mhonda0119/Passion-v2/Inventor/Passion-v2-6/DMM/battery-stopper-assembly-multiple.stp

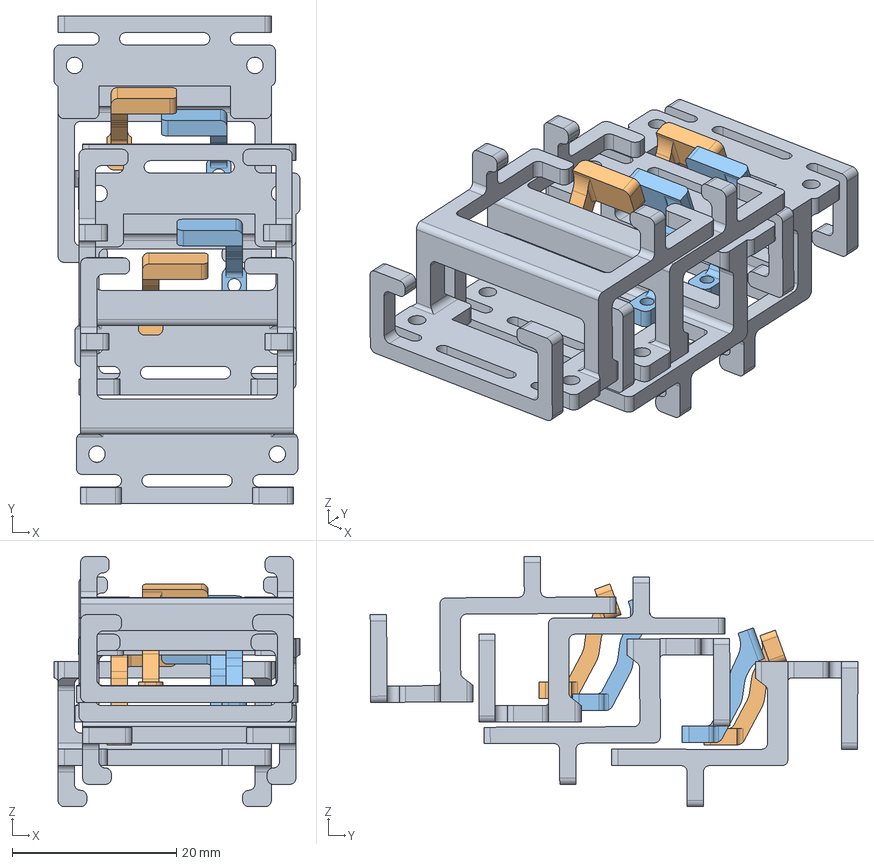
[picture p1: CAD file, 2025-02-09]
Inventor/Passion-v2-6/DMM/battery-stopper-assembly-multiple.stp
30.0 x 59.5 x 30.5 mm
battery-stopper-3 x 4
battery-stopper-1 x 2
battery-stopper-1_1 x 2
