mhonda0119/Passion-v2/Eagle/circuit-shape.dxf

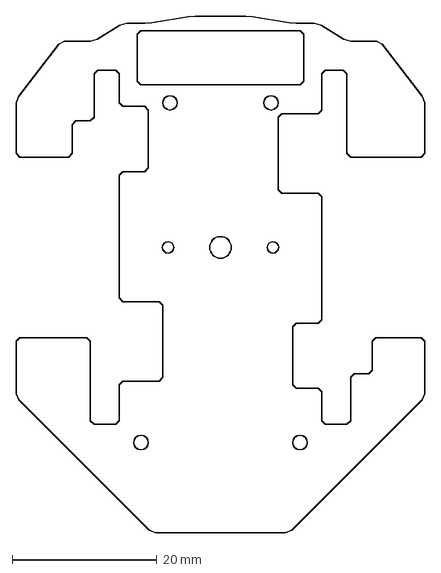
[picture p2: CAD file, 2025-03-03]
Eagle/circuit-shape.dxf
56.5 x 71.5 mm
