mhonda0119/Passion-v2/Inventor/Passion-v2-5/Origin/STEP/7075/motormount-l-v2-4.stp

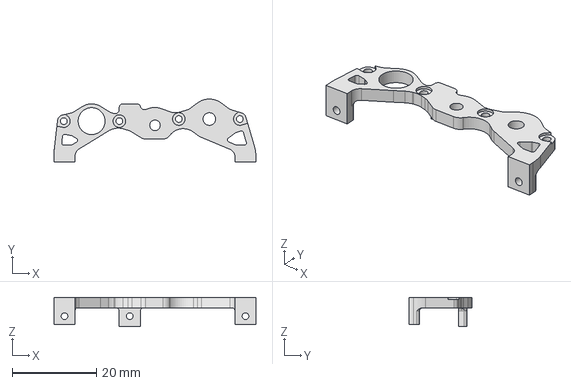
[picture p3: CAD file, 2025-02-07]
Inventor/Passion-v2-5/Origin/STEP/7075/motormount-l-v2-4.stp
48.0 x 14.9 x 7.00 mm
