mhonda0119/Passion-v2/Inventor/Passion-v2-5/Origin/STEP/POM/fan-concreate-v2-4.stp

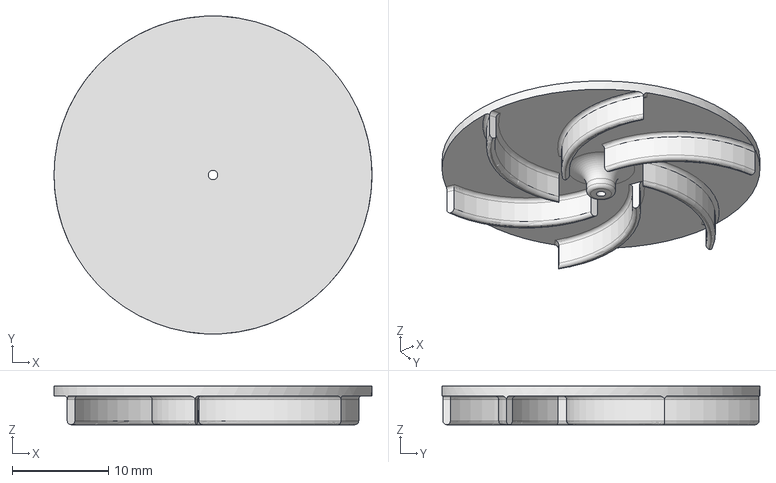
[picture p4: CAD file, 2025-02-07]
Inventor/Passion-v2-5/Origin/STEP/POM/fan-concreate-v2-4.stp
33.0 x 33.0 x 4.00 mm
