mhonda0119/Passion-v2/Inventor/Passion-v2-5/STEP/chassis.stp

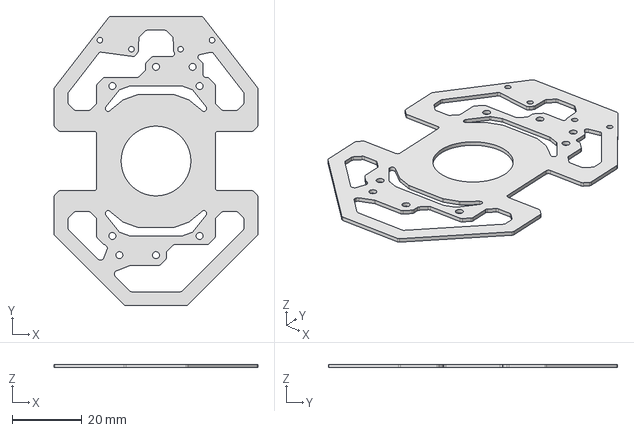
[picture p5: CAD file, 2025-02-08]
Inventor/Passion-v2-5/STEP/chassis.stp
58.5 x 83.0 x 1.00 mm
