mhonda0119/Passion-v2/Inventor/Passion-v2-5/試作/encodersupporter.stp

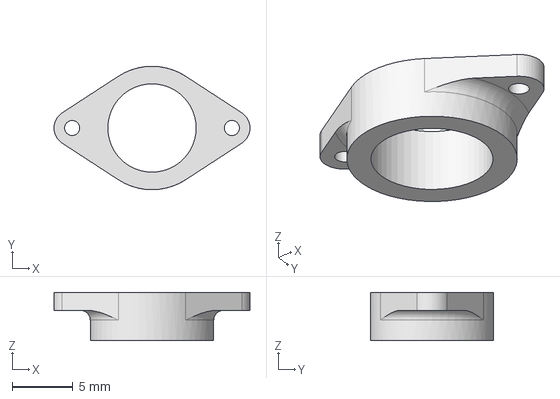
[picture p6: CAD file, 2025-02-07]
Inventor/Passion-v2-5/試作/encodersupporter.stp
16.2 x 10.2 x 4.00 mm
