mhonda0119/Passion-v2/Inventor/Passion-v2-6/CarbonLab/chassis.stp

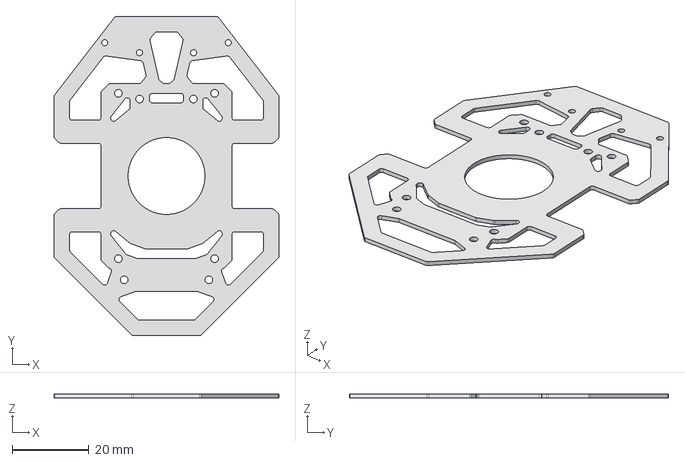
[picture p7: CAD file, 2025-02-09]
Inventor/Passion-v2-6/CarbonLab/chassis.stp
58.5 x 83.0 x 1.00 mm
