mhonda0119/Passion-v2/Inventor/Passion-v2-6/DMM/battery-stopper-1.stp

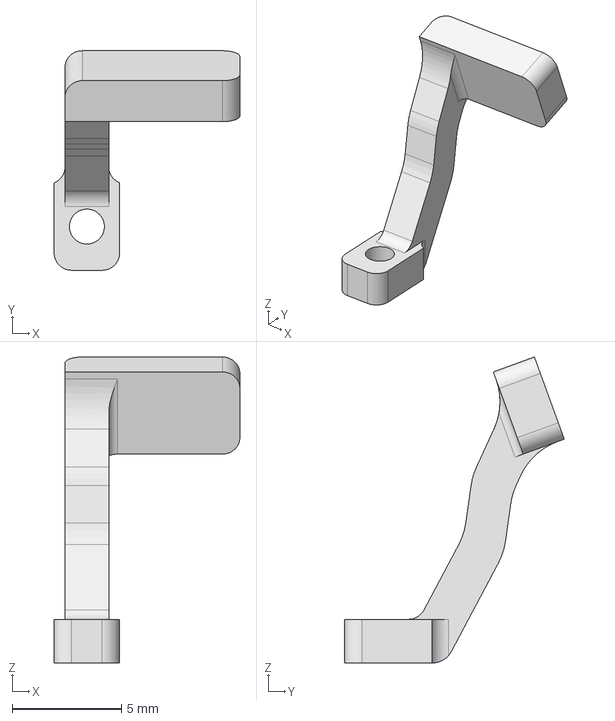
[picture p8: CAD file, 2025-02-09]
Inventor/Passion-v2-6/DMM/battery-stopper-1.stp
8.50 x 10.0 x 14.0 mm
