mhonda0119/Passion-v2/Inventor/Passion-v2-6/fanmotor-mount-1.stp

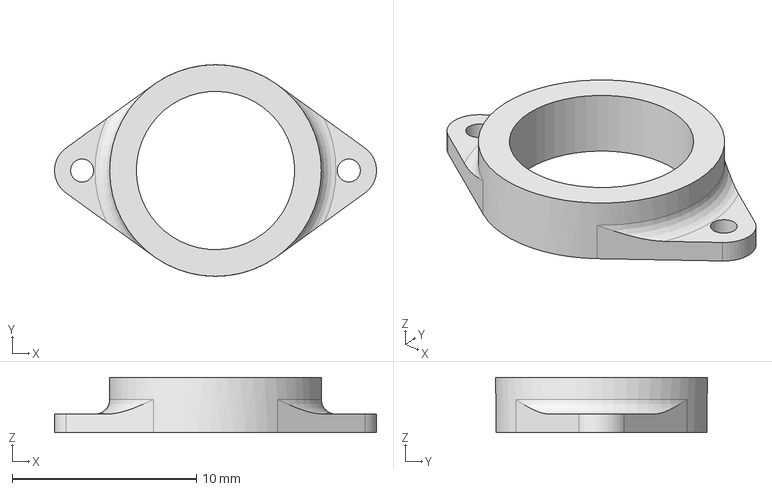
[picture p9: CAD file, 2025-03-03]
Inventor/Passion-v2-6/fanmotor-mount-1.stp
17.5 x 11.5 x 3.00 mm
