mhonda0119/Passion-v2/Inventor/Passion-v2-6/JLCPCB/sensorbase.stp

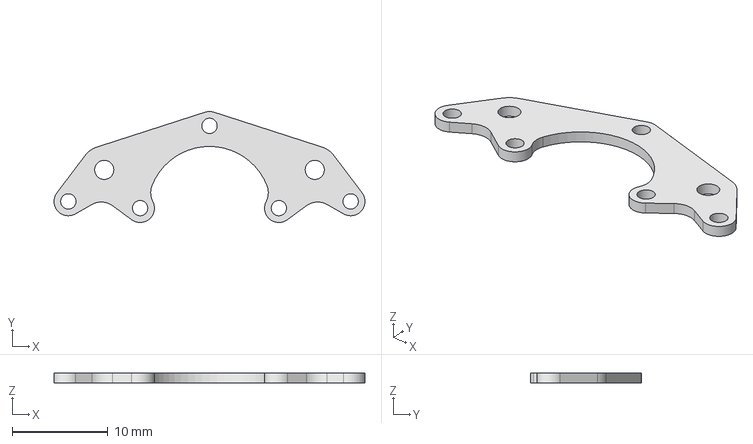
[picture p10: CAD file, 2025-02-09]
Inventor/Passion-v2-6/JLCPCB/sensorbase.stp
32.5 x 11.6 x 1.00 mm
