mhonda0119/Passion-v2/Inventor/Passion-v2-6/Origin/encodersupporter.stp

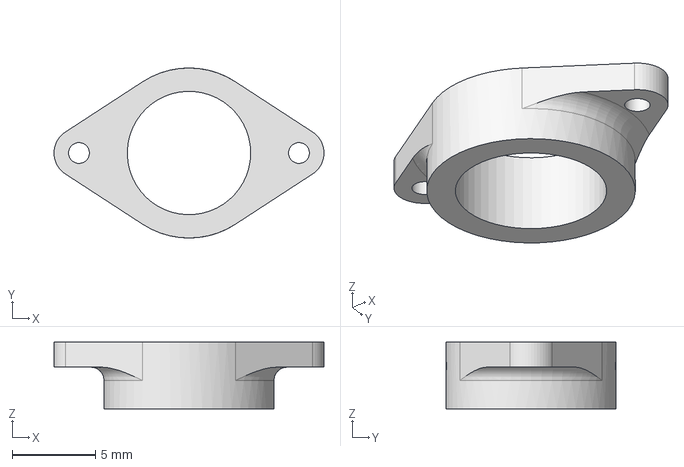
[picture p11: CAD file, 2025-03-03]
Inventor/Passion-v2-6/Origin/encodersupporter.stp
16.2 x 10.2 x 4.00 mm
