mhonda0119/Passion-v2/Eagle/sensor-hub-fr-fl.dxf

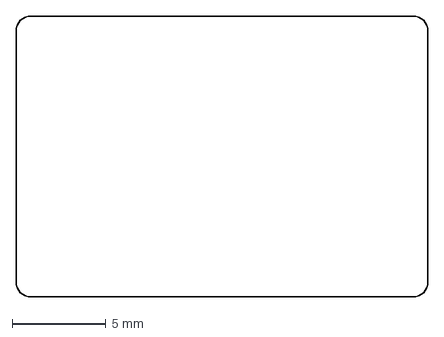
[picture p12: CAD file, 2025-03-03]
Eagle/sensor-hub-fr-fl.dxf
22.0 x 15.0 mm
