mhonda0119/Passion-v2/Inventor/Passion-v2-5/STEP/motorsupporter.stp

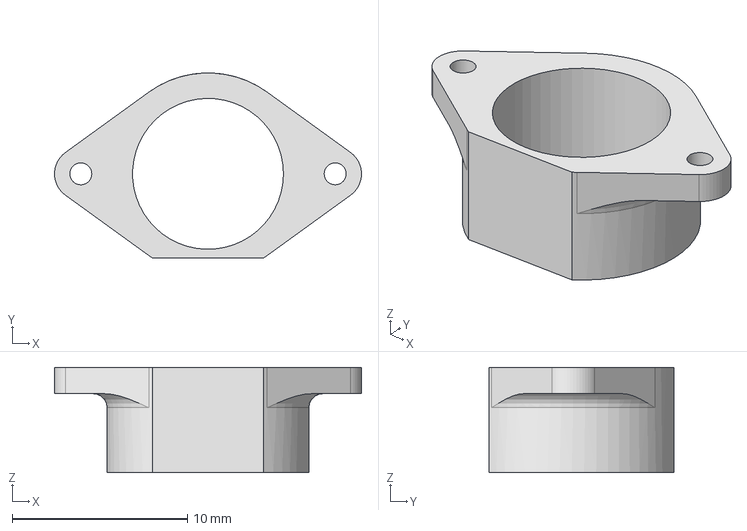
[picture p13: CAD file, 2025-02-08]
Inventor/Passion-v2-5/STEP/motorsupporter.stp
17.5 x 10.6 x 6.00 mm
