mhonda0119/Passion-v2/Inventor/Passion-v2-6/DMM/encoder-gear-spacer-multiple.stp

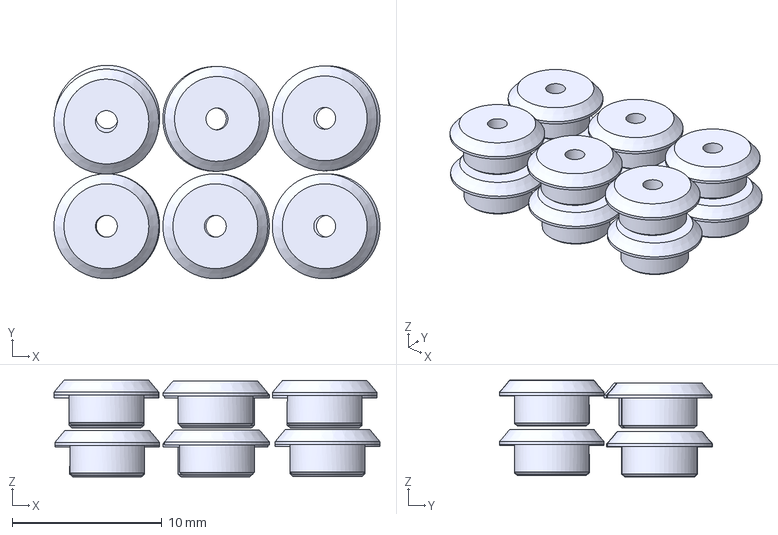
[picture p14: CAD file, 2025-02-09]
Inventor/Passion-v2-6/DMM/encoder-gear-spacer-multiple.stp
21.7 x 14.2 x 6.44 mm
Encoder-Gear-Spacer x 12
