mhonda0119/Passion-v2/Inventor/Passion-v2-6/JLCPCB/fan-concreate.stp

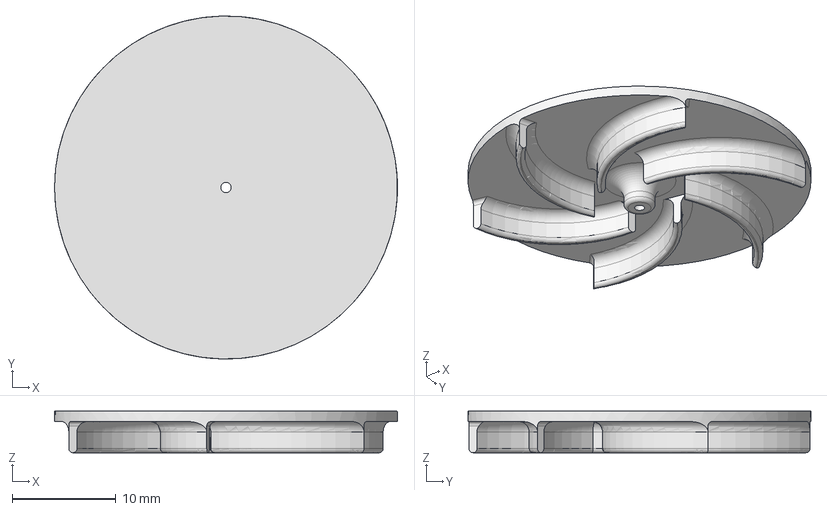
[picture p15: CAD file, 2025-02-09]
Inventor/Passion-v2-6/JLCPCB/fan-concreate.stp
33.0 x 33.0 x 4.00 mm
