mhonda0119/Passion-v2/Eagle/sensor-hub-lr.dxf

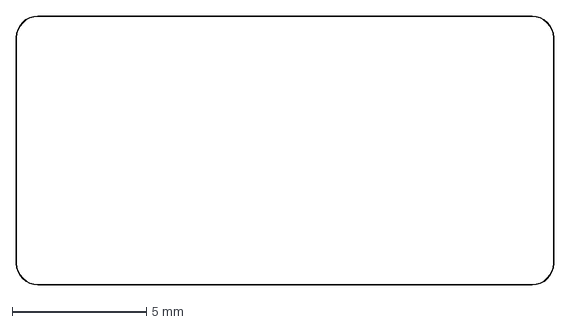
[picture p16: CAD file, 2025-03-03]
Eagle/sensor-hub-lr.dxf
20.0 x 10.0 mm
