mhonda0119/Passion-v2/Inventor/Passion-v2-5/試作/sensormount -fl.stp

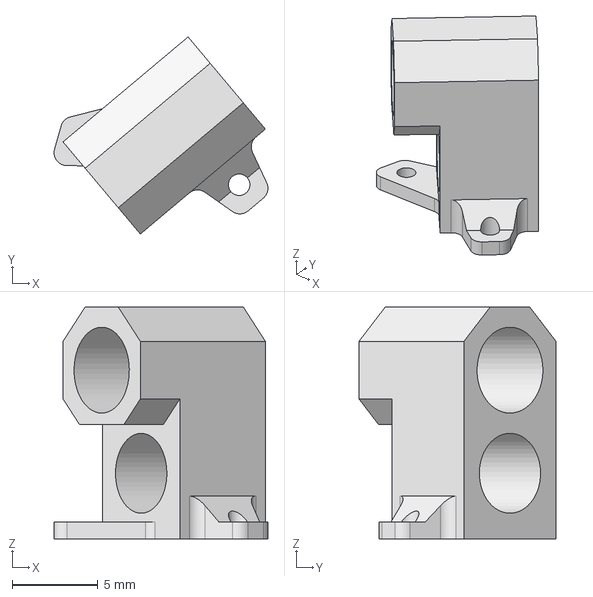
[picture p17: CAD file, 2025-02-07]
Inventor/Passion-v2-5/試作/sensormount -fl.stp
12.4 x 11.5 x 13.5 mm
