mhonda0119/Passion-v2/Inventor/Passion-v2-6/JLCPCB/motormount-l.stp

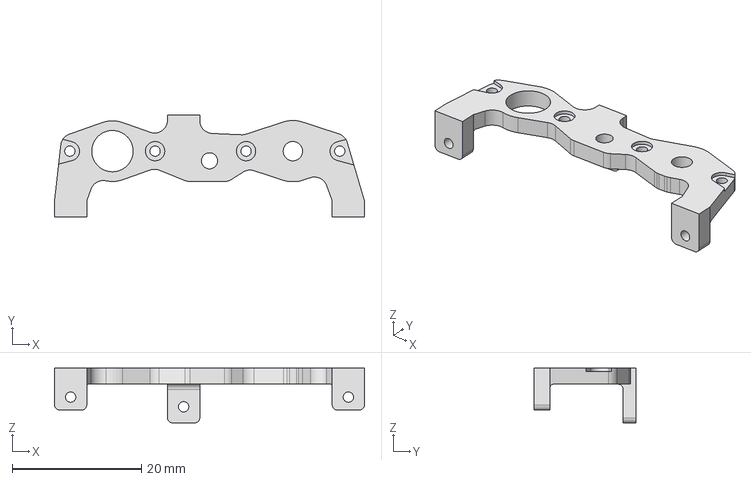
[picture p18: CAD file, 2025-02-09]
Inventor/Passion-v2-6/JLCPCB/motormount-l.stp
48.0 x 15.8 x 8.50 mm
