mhonda0119/Passion-v2/Eagle/circuit-tplace.dxf

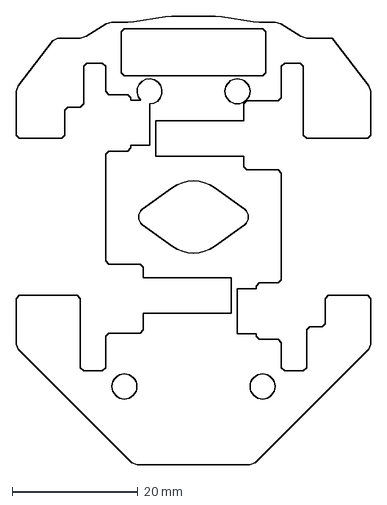
[picture p19: CAD file, 2025-02-09]
Eagle/circuit-tplace.dxf
56.5 x 71.5 mm
