mhonda0119/Passion-v2/Inventor/Passion-v2-5/試作/motormount-l.stp

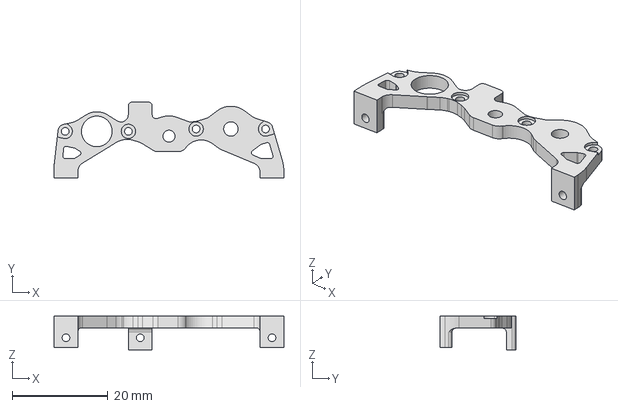
[picture p20: CAD file, 2025-02-07]
Inventor/Passion-v2-5/試作/motormount-l.stp
48.0 x 15.8 x 7.00 mm
