mhonda0119/Passion-v2/Inventor/Passion-v2-5/試作/frontsensorholder.stp

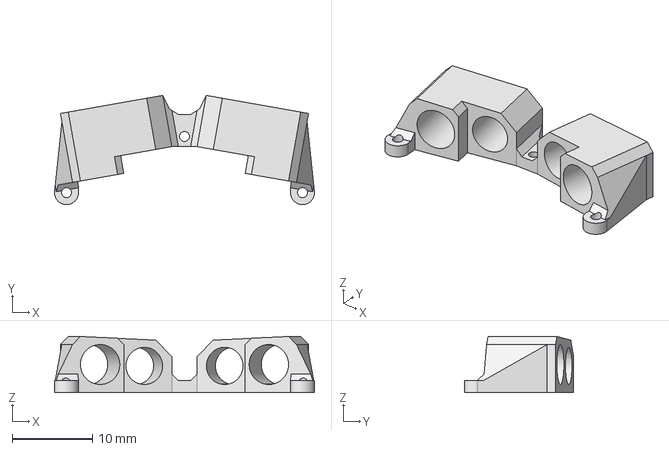
[picture p21: CAD file, 2025-02-07]
Inventor/Passion-v2-5/試作/frontsensorholder.stp
32.5 x 13.6 x 7.00 mm
