mhonda0119/Passion-v2/Inventor/Passion-v2-6/DMM/battery-stopper-3.stp

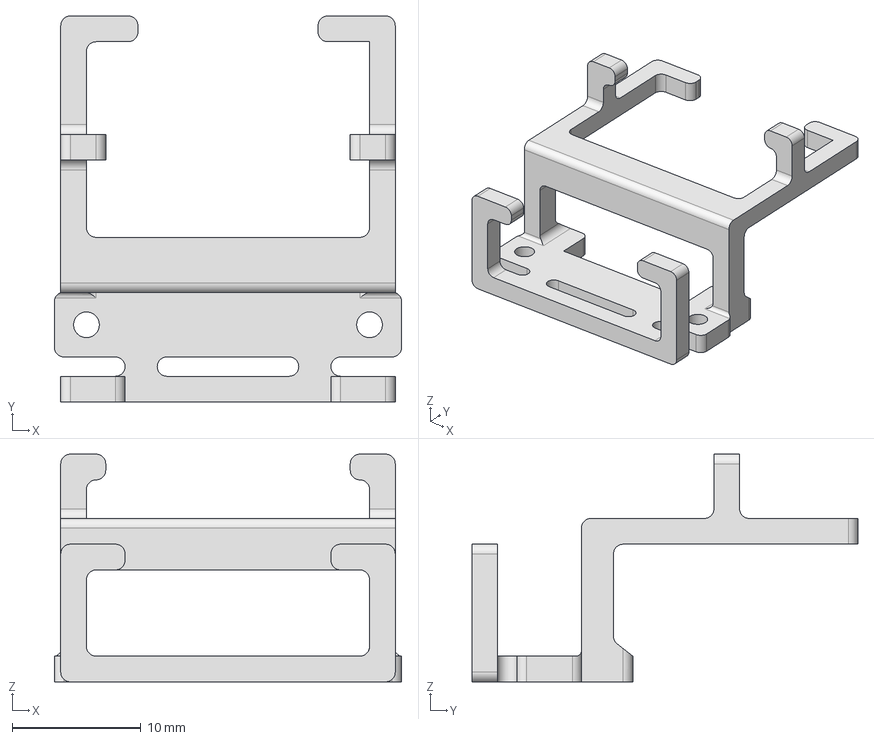
[picture p22: CAD file, 2025-02-09]
Inventor/Passion-v2-6/DMM/battery-stopper-3.stp
27.0 x 30.0 x 17.7 mm
