mhonda0119/Passion-v2/Inventor/Passion-v2-6/DMM/Encoder-Gear-Spacer.stp

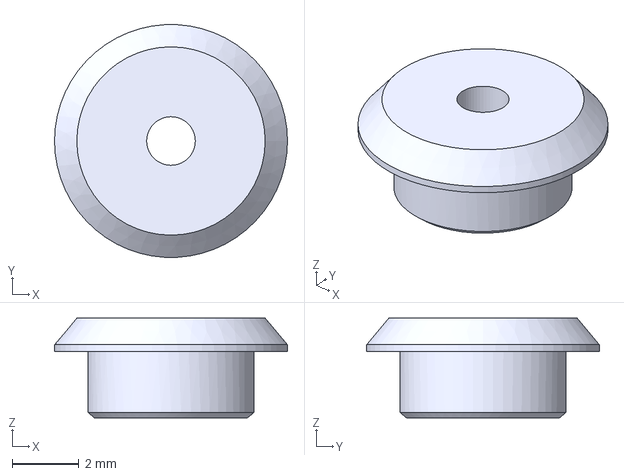
[picture p23: CAD file, 2025-02-09]
Inventor/Passion-v2-6/DMM/Encoder-Gear-Spacer.stp
7.00 x 6.99 x 3.00 mm
