mhonda0119/Passion-v2/Inventor/Passion-v2-5/試作/fanmotor-mount-2-1.stp

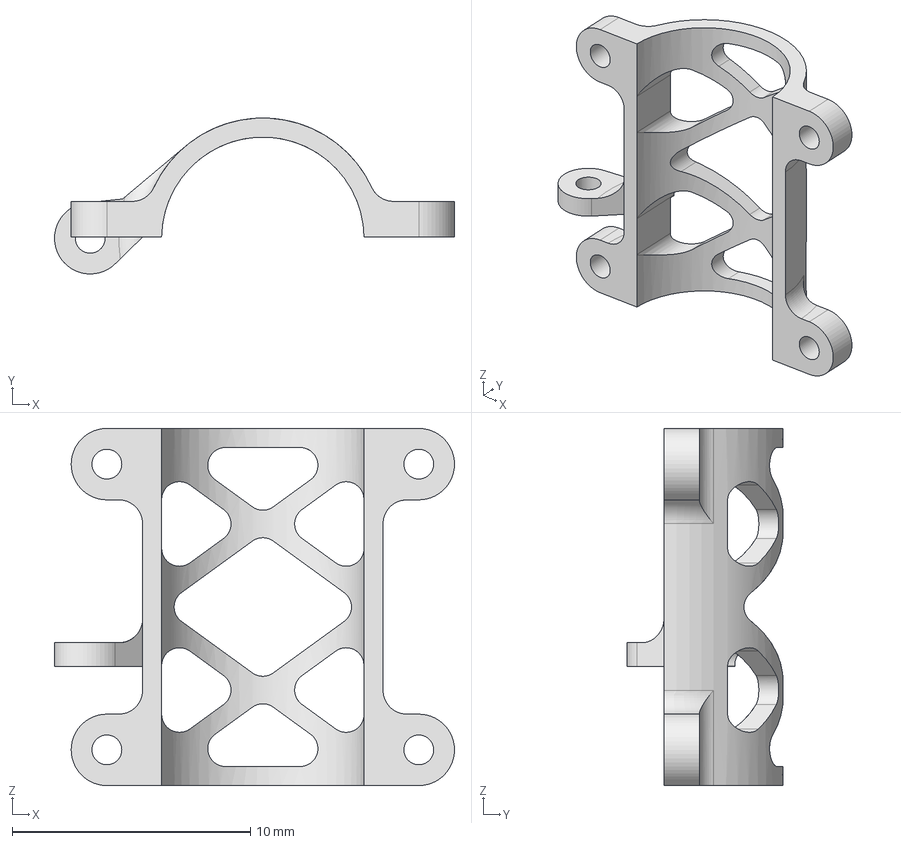
[picture p24: CAD file, 2025-02-07]
Inventor/Passion-v2-5/試作/fanmotor-mount-2-1.stp
16.8 x 6.55 x 15.0 mm
