mhonda0119/Passion-v2/Inventor/Passion-v2-6/DMM/fan-concreate-multiple.stp

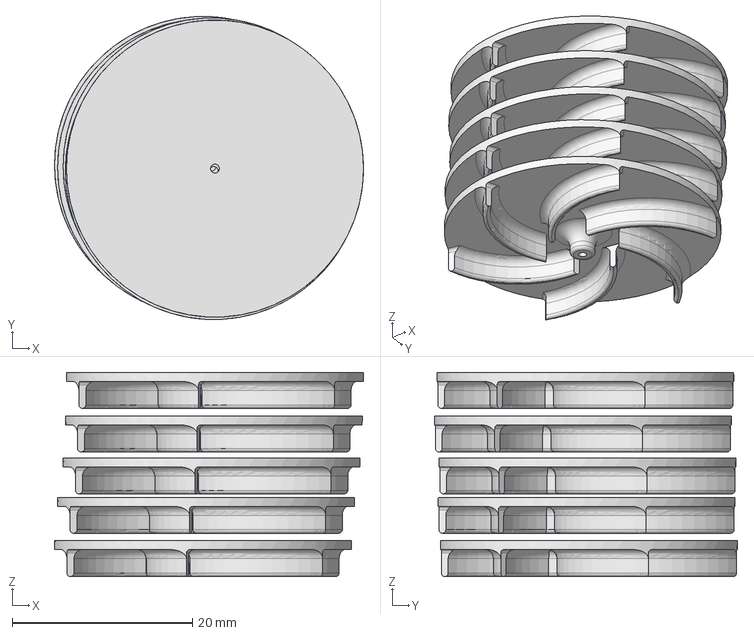
[picture p25: CAD file, 2025-02-09]
Inventor/Passion-v2-6/DMM/fan-concreate-multiple.stp
34.3 x 33.7 x 22.7 mm
fan-concreate x 5
