mhonda0119/Passion-v2/Inventor/Passion-v2-5/試作/circuit.stp

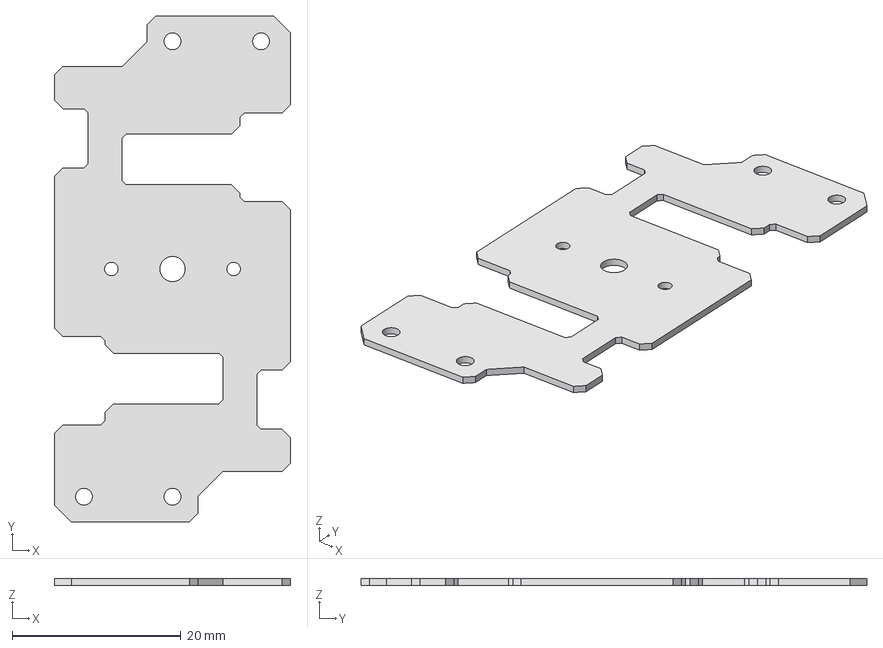
[picture p26: CAD file, 2025-02-07]
Inventor/Passion-v2-5/試作/circuit.stp
28.0 x 60.0 x 0.8 mm
