mhonda0119/Passion-v2/Inventor/Passion-v2-6/DMM/ALL.stp

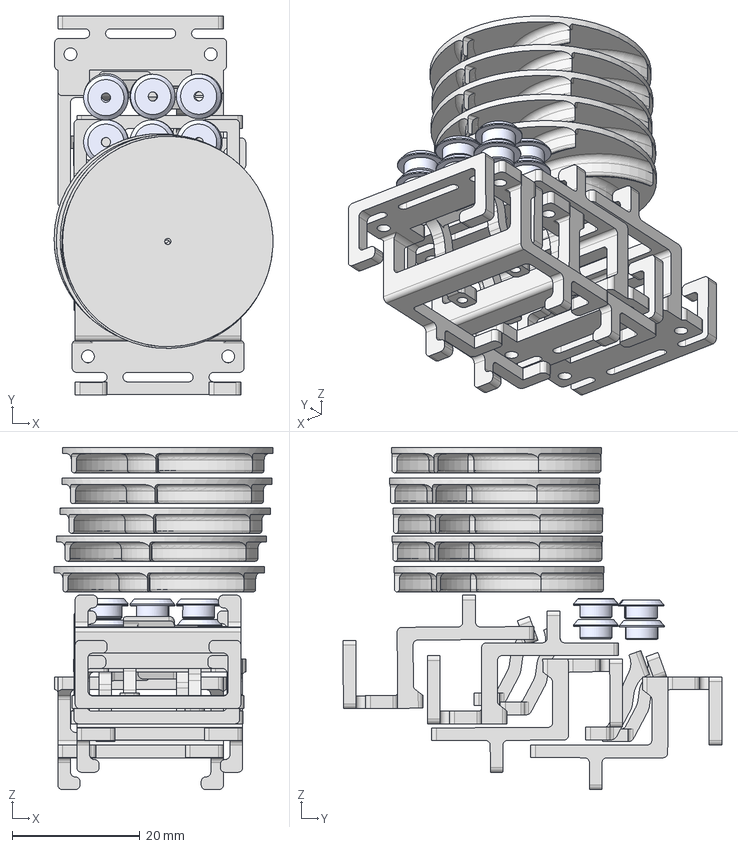
[picture p27: CAD file, 2025-02-09]
Inventor/Passion-v2-6/DMM/ALL.stp
34.3 x 59.5 x 53.7 mm
battery-stopper-3 x 4
battery-stopper-1 x 2
battery-stopper-1_1 x 2
Encoder-Gear-Spacer x 12
fan-concreate x 5
