mhonda0119/Passion-v2/Inventor/Passion-v2-5/試作/sensorbase.stp

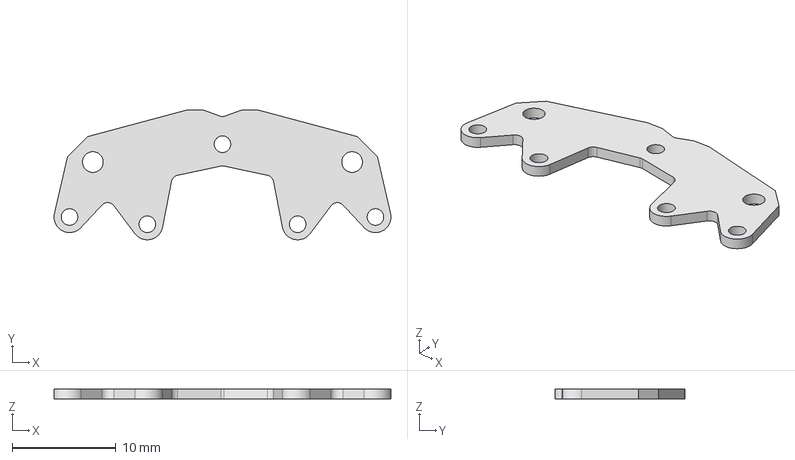
[picture p29: CAD file, 2025-02-07]
Inventor/Passion-v2-5/試作/sensorbase.stp
32.5 x 12.5 x 1.00 mm
