mhonda0119/Passion-v2/(list of files, cad)

Other CAD files:
Inventor/Passion-v2-5/Origin/STEP/7075/motormount-r-v2-4.stp
Inventor/Passion-v2-5/試作/fanmotor-mount-1.stp
Inventor/Passion-v2-6/encodersupporter.stp
Inventor/Passion-v2-6/Origin/fanmotor-mount-1.stp
Inventor/Passion-v2-6/Origin/STEP/7075/motormount-r-v2-4.stp
Inventor/Passion-v2-5/STEP/sensormount -fr.stp
Inventor/Passion-v2-5/STEP/sensorbase.stp
Inventor/Passion-v2-6/JLCPCB/frontsensorholder.stp
Inventor/Passion-v2-5/STEP/sensormount -fl.stp
Inventor/Passion-v2-5/試作/chassis.stp
Inventor/Passion-v2-6/JLCPCB/motormount-r.stp
Inventor/Passion-v2-5/STEP/fan-concreate.stp
Inventor/Passion-v2-5/STEP/motormount-l.stp
Inventor/Passion-v2-5/STEP/circuit.stp
Inventor/Passion-v2-5/試作/sensormount -fr.stp
Inventor/Passion-v2-6/DMM/battery-stopper-1-mirror.stp
Inventor/Passion-v2-5/STEP/encodersupporter.stp
Inventor/Passion-v2-5/試作/fanmotor-mount-2.stp
Inventor/Passion-v2-5/STEP/frontsensorholder.stp
Inventor/Passion-v2-5/試作/motorsupporter.stp
Inventor/Passion-v2-5/STEP/fanmotor-mount-1.stp
Inventor/Passion-v2-5/STEP/motormount-r.stp
Inventor/Passion-v2-1/OldVersions/Passion-v2.0058.iam
Inventor/Passion-v2-1/Origin/OldVersions/chassis-2 -センサねじ止めバージョン.0008.ipt
Inventor/Passion-v2-1/Origin/OldVersions/chassis-2.0009.ipt
Inventor/Passion-v2-1/Origin/OldVersions/chassis-センサねじ止めバージョン.0080.ipt
Inventor/Passion-v2-1/Origin/OldVersions/chassis.0091.ipt
Inventor/Passion-v2-1/Origin/OldVersions/circuit.0044.ipt
Inventor/Passion-v2-1/Origin/OldVersions/encoderauxiliary.0009.ipt
Inventor/Passion-v2-1/Origin/OldVersions/fan.0003.ipt
Inventor/Passion-v2-1/Origin/OldVersions/fanauxiliary.0007.ipt
Inventor/Passion-v2-1/Origin/OldVersions/motorauxiliary.0008.ipt
Inventor/Passion-v2-1/Origin/OldVersions/motormount.0078.ipt
Inventor/Passion-v2-1/Origin/OldVersions/sensorcircuit.0023.ipt
Inventor/Passion-v2-1/Origin/OldVersions/sensorholder.0003.ipt
Inventor/Passion-v2-1/Origin/OldVersions/sensorholder_2.0009.ipt
Inventor/Passion-v2-1/Origin/OldVersions/sensorholder_3.0005.ipt
Inventor/Passion-v2-1/Origin/OldVersions/spacer-outwheel-m3-1.0001.ipt
Inventor/Passion-v2-1/Origin/OldVersions/spacer_m2.0001.ipt
Inventor/Passion-v2-1/Origin/chassis-2 -センサねじ止めバージョン.ipt
Inventor/Passion-v2-1/Origin/chassis-2.ipt
Inventor/Passion-v2-1/Origin/chassis-センサねじ止めバージョン.ipt
Inventor/Passion-v2-1/Origin/chassis.ipt
Inventor/Passion-v2-1/Origin/circuit.ipt
Inventor/Passion-v2-1/Origin/encoderauxiliary.ipt
Inventor/Passion-v2-1/Origin/fan.ipt
Inventor/Passion-v2-1/Origin/fanauxiliary.ipt
Inventor/Passion-v2-1/Origin/motorauxiliary.ipt
Inventor/Passion-v2-1/Origin/motormount.ipt
Inventor/Passion-v2-1/Origin/sensorcircuit.ipt
Inventor/Passion-v2-1/Origin/sensorholder.ipt
Inventor/Passion-v2-1/Origin/spacer_m2.ipt
Inventor/Passion-v2-1/Passion-v2.iam
Inventor/Passion-v2-2/Common/OldVersions/sensorbase.0001.ipt
Inventor/Passion-v2-2/OldVersions/Passion-v2.0061.iam
Inventor/Passion-v2-2/Origin/OldVersions/chassis.0072.ipt
Inventor/Passion-v2-2/Origin/OldVersions/circuit.0028.ipt
Inventor/Passion-v2-2/Origin/OldVersions/encodersupporter.0009.ipt
Inventor/Passion-v2-2/Origin/OldVersions/fan.0004.ipt
Inventor/Passion-v2-2/Origin/OldVersions/motormount-l.0033.ipt
Inventor/Passion-v2-2/Origin/OldVersions/motormount-r.0034.ipt
Inventor/Passion-v2-2/Origin/OldVersions/motorsupporter.0006.ipt
Inventor/Passion-v2-2/Origin/OldVersions/sensormount-2.0028.ipt
Inventor/Passion-v2-2/Origin/OldVersions/sensormount.0026.ipt
Inventor/Passion-v2-3/OldVersions/Passion-v2.0095.iam
Inventor/Passion-v2-3/Origin/OldVersions/circuit.0052.ipt
Inventor/Passion-v2-3/Origin/OldVersions/encodersupporter.0017.ipt
Inventor/Passion-v2-3/Origin/OldVersions/fan-concreate.0007.ipt
Inventor/Passion-v2-3/Origin/OldVersions/fanmotor-mount-1.0005.ipt
Inventor/Passion-v2-3/Origin/OldVersions/fanmotor-mount-2-1.0016.ipt
Inventor/Passion-v2-3/Origin/OldVersions/fanmotor-mount-2.0014.ipt
Inventor/Passion-v2-3/Origin/OldVersions/frontsensorholder.0022.ipt
Inventor/Passion-v2-3/Origin/OldVersions/motormount-l.0056.ipt
Inventor/Passion-v2-3/Origin/OldVersions/motormount-r.0059.ipt
Inventor/Passion-v2-3/Origin/OldVersions/motorsupporter.0016.ipt
Inventor/Passion-v2-3/Origin/OldVersions/sensorbase.0020.ipt
Inventor/Passion-v2-3/Origin/STEP/MJF/fanmotor-mount-2-1.stp
Inventor/Passion-v2-3/Origin/STEP/MJF/fanmotor-mount-2.stp
Inventor/Passion-v2-3/Origin/STEP/MJF/frontsensorholder.stp
Inventor/Passion-v2-3/Origin/STEP/POM/encodersupporter.stp
Inventor/Passion-v2-3/Origin/STEP/POM/fan-concreate.stp
Inventor/Passion-v2-3/Origin/STEP/POM/fanmotor-mount-1.stp
Inventor/Passion-v2-3/Origin/STEP/drivesystem-chassis-8520-0.5.ipt
Inventor/Passion-v2-4/Common/OldVersions/m2-超極低頭十字穴付きボルト-3mm.0001.ipt
Inventor/Passion-v2-4/Common/m2-超極低頭十字穴付きボルト-3mm.ipt
Inventor/Passion-v2-4/OldVersions/Passion-v2.0106.iam
Inventor/Passion-v2-4/Origin/OldVersions/circuit.0052.ipt
Inventor/Passion-v2-4/Origin/OldVersions/encodersupporter.0019.ipt
Inventor/Passion-v2-4/Origin/OldVersions/fan-concreate.0011.ipt
Inventor/Passion-v2-4/Origin/OldVersions/fanmotor-mount-1.0005.ipt
Inventor/Passion-v2-4/Origin/OldVersions/fanmotor-mount-2-1.0016.ipt
Inventor/Passion-v2-4/Origin/OldVersions/fanmotor-mount-2.0014.ipt
Inventor/Passion-v2-4/Origin/OldVersions/frontsensorholder.0022.ipt
Inventor/Passion-v2-4/Origin/OldVersions/motormount-l.0074.ipt
Inventor/Passion-v2-4/Origin/OldVersions/motormount-r.0090.ipt
Inventor/Passion-v2-4/Origin/OldVersions/motorsupporter.0018.ipt
Inventor/Passion-v2-4/Origin/OldVersions/sensorbase.0021.ipt
Inventor/Passion-v2-4/Origin/OldVersions/sensormount -fr.0042.ipt
Inventor/Passion-v2-4/Origin/circuit.ipt
Inventor/Passion-v2-4/Origin/encodersupporter.ipt
Inventor/Passion-v2-4/Origin/fan-concreate.ipt
Inventor/Passion-v2-4/Origin/fanmotor-mount-1.ipt
Inventor/Passion-v2-4/Origin/fanmotor-mount-2-1.ipt
Inventor/Passion-v2-4/Origin/fanmotor-mount-2.ipt
Inventor/Passion-v2-4/Origin/frontsensorholder.ipt
Inventor/Passion-v2-4/Origin/motormount-l.ipt
Inventor/Passion-v2-4/Origin/motormount-r.ipt
Inventor/Passion-v2-4/Origin/motorsupporter.ipt
Inventor/Passion-v2-4/Origin/sensorbase.ipt
Inventor/Passion-v2-4/Origin/sensormount -fr.ipt
Inventor/Passion-v2-4/Passion-v2.iam
Inventor/Passion-v2-5/Common/M2_locknut.ipt
Inventor/Passion-v2-5/Common/M3_bolt.ipt
Inventor/Passion-v2-5/Common/M3_locknut.ipt
Inventor/Passion-v2-5/Common/OldVersions/M3_bolt.0003.ipt
Inventor/Passion-v2-5/Common/OldVersions/m1.6_2_なべ小ねじ0番.0002.ipt
Inventor/Passion-v2-5/Common/OldVersions/m1.6_3_なべ小ねじ0番.0002.ipt
Inventor/Passion-v2-5/Common/OldVersions/m1.6_4_なべ小ねじ0番.0001.ipt
Inventor/Passion-v2-5/Common/OldVersions/m1.6_5_なべ小ねじ0番.0002.ipt
Inventor/Passion-v2-5/Common/OldVersions/m1.6_nut.0002.ipt
Inventor/Passion-v2-5/Common/OldVersions/m2-5.5-spacer.0001.ipt
Inventor/Passion-v2-5/Common/OldVersions/m2-超極低頭十字穴付きボルト-3mm.0001.ipt
Inventor/Passion-v2-5/Common/OldVersions/spacer_m1.6_circuit.0005.ipt
Inventor/Passion-v2-5/Common/bearing_MF63ZZ.ipt
Inventor/Passion-v2-5/Common/bearing_SMR63ZZ.ipt
Inventor/Passion-v2-5/Common/m1.6_2_なべ小ねじ0番.ipt
Inventor/Passion-v2-5/Common/m1.6_3_なべ小ねじ0番.ipt
Inventor/Passion-v2-5/Common/m1.6_4_なべ小ねじ0番.ipt
Inventor/Passion-v2-5/Common/m1.6_5_なべ小ねじ0番.ipt
Inventor/Passion-v2-5/Common/m1.6_nut.ipt
Inventor/Passion-v2-5/Common/m2-5.5-spacer.ipt
Inventor/Passion-v2-5/Common/m2-超極低頭十字穴付きボルト-3mm.ipt
Inventor/Passion-v2-5/Common/sensormount-r.ipt
Inventor/Passion-v2-5/Common/shaft_m3_bolt.ipt
Inventor/Passion-v2-5/Common/spacer-outwheel-m3-1.ipt
Inventor/Passion-v2-5/Common/spacer_inwheel_1.1.ipt
Inventor/Passion-v2-5/Common/spacer_inwheel_2.5.ipt
Inventor/Passion-v2-5/Common/spacer_m1.6_circuit.ipt
Inventor/Passion-v2-5/Common/spacer_outwheel_1.6.ipt
Inventor/Passion-v2-5/OldVersions/Passion-v2.0126.iam
Inventor/Passion-v2-5/OldVersions/chassis.0007.ipt
Inventor/Passion-v2-5/OldVersions/circuit.0001.ipt
Inventor/Passion-v2-5/OldVersions/motormount.0009.ipt
Inventor/Passion-v2-5/Origin/OldVersions/chassis.0104.ipt
Inventor/Passion-v2-5/Origin/OldVersions/circuit.0068.ipt
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
