mhonda0119/Passion-v2/Eagle/passion-v2-1/sensor-hub-lr.brd

## EAGLE design Eagle/passion-v2-1/sensor-hub-lr.brd (2025-03-03)

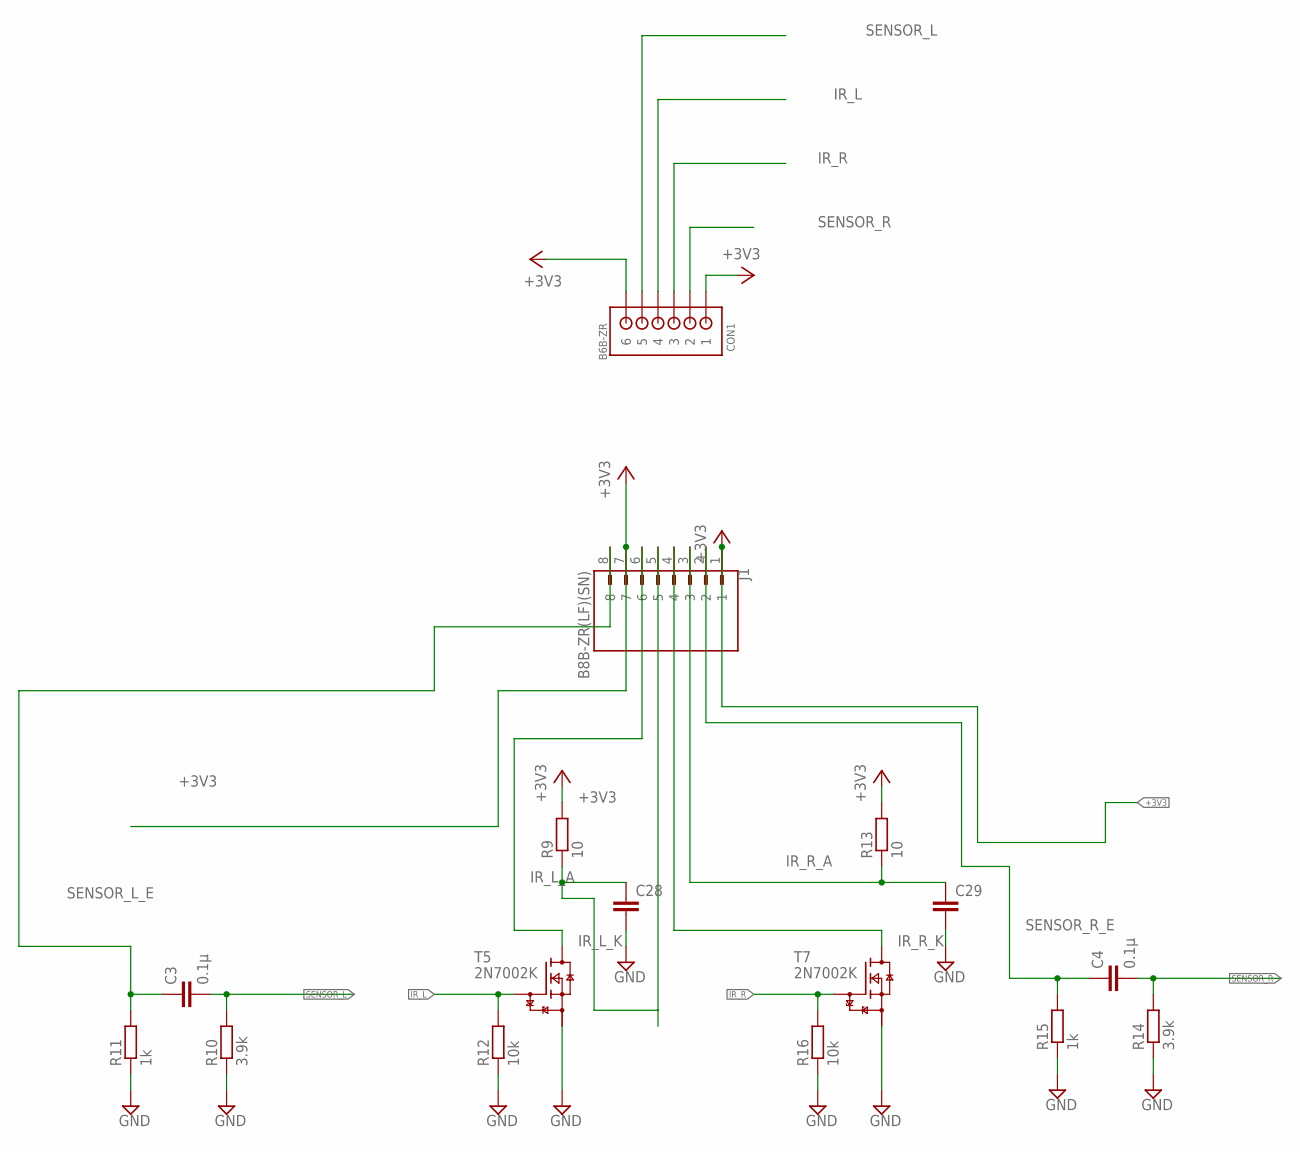
[picture p30: schematic sensor-hub-lr.sch]

Parts:
C3, C4: 0.1μ; C0603
C28, C29: C-EUC1206; C1206
CON1: B6B-ZR
J1: B8B-ZR(LF)(SN); JST_B8B-ZR(LF)(SN)
R9, R13: 10; R0603
R10, R14: 3.9k; R0603
R11, R15: 1k; R0603
R12, R16: 10k; R0603
T5, T7: 2N7002K; SOT23

Connections:
+3V3: CON1.1, CON1.6, J1.1, J1.7, R9.2, R13.2
GND: C28.2, C29.2, R10.1, R11.1, R12.1, R14.1, R15.1, R16.1, T5.2 (S), T7.2 (S)
IR_L: CON1.4, R12.2, T5.1 (G)
IR_L_A: C28.1, J1.5, R9.1
IR_L_K: J1.6, T5.3 (D)
IR_R: CON1.3, R16.2, T7.1 (G)
IR_R_A: C29.1, J1.3, R13.1
IR_R_K: J1.4, T7.3 (D)
SENSOR_L: C3.2, CON1.5, R10.2
SENSOR_L_E: C3.1, J1.8, R11.2
SENSOR_R: C4.2, CON1.2, R14.2
SENSOR_R_E: C4.1, J1.2, R15.2

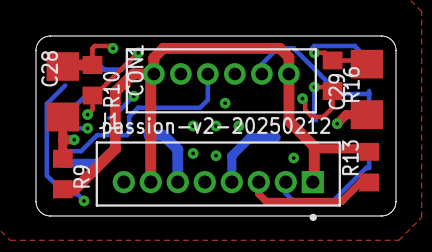
[picture p31: board sensor-hub-lr.brd from above]

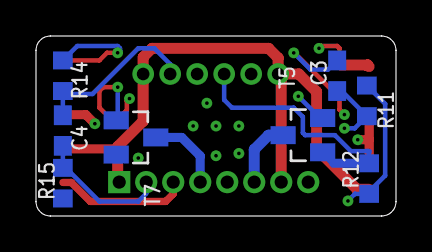
[picture p32: board sensor-hub-lr.brd from below]

Board: 4 copper layers, 20.0 x 10.0 mm, 16 parts (8 on the bottom side), 12 nets.
