mhonda0119/Passion-v2/Eagle/passion-v2-1/passion-v2-1.brd

## EAGLE design Eagle/passion-v2-1/passion-v2-1.brd (2025-03-03)

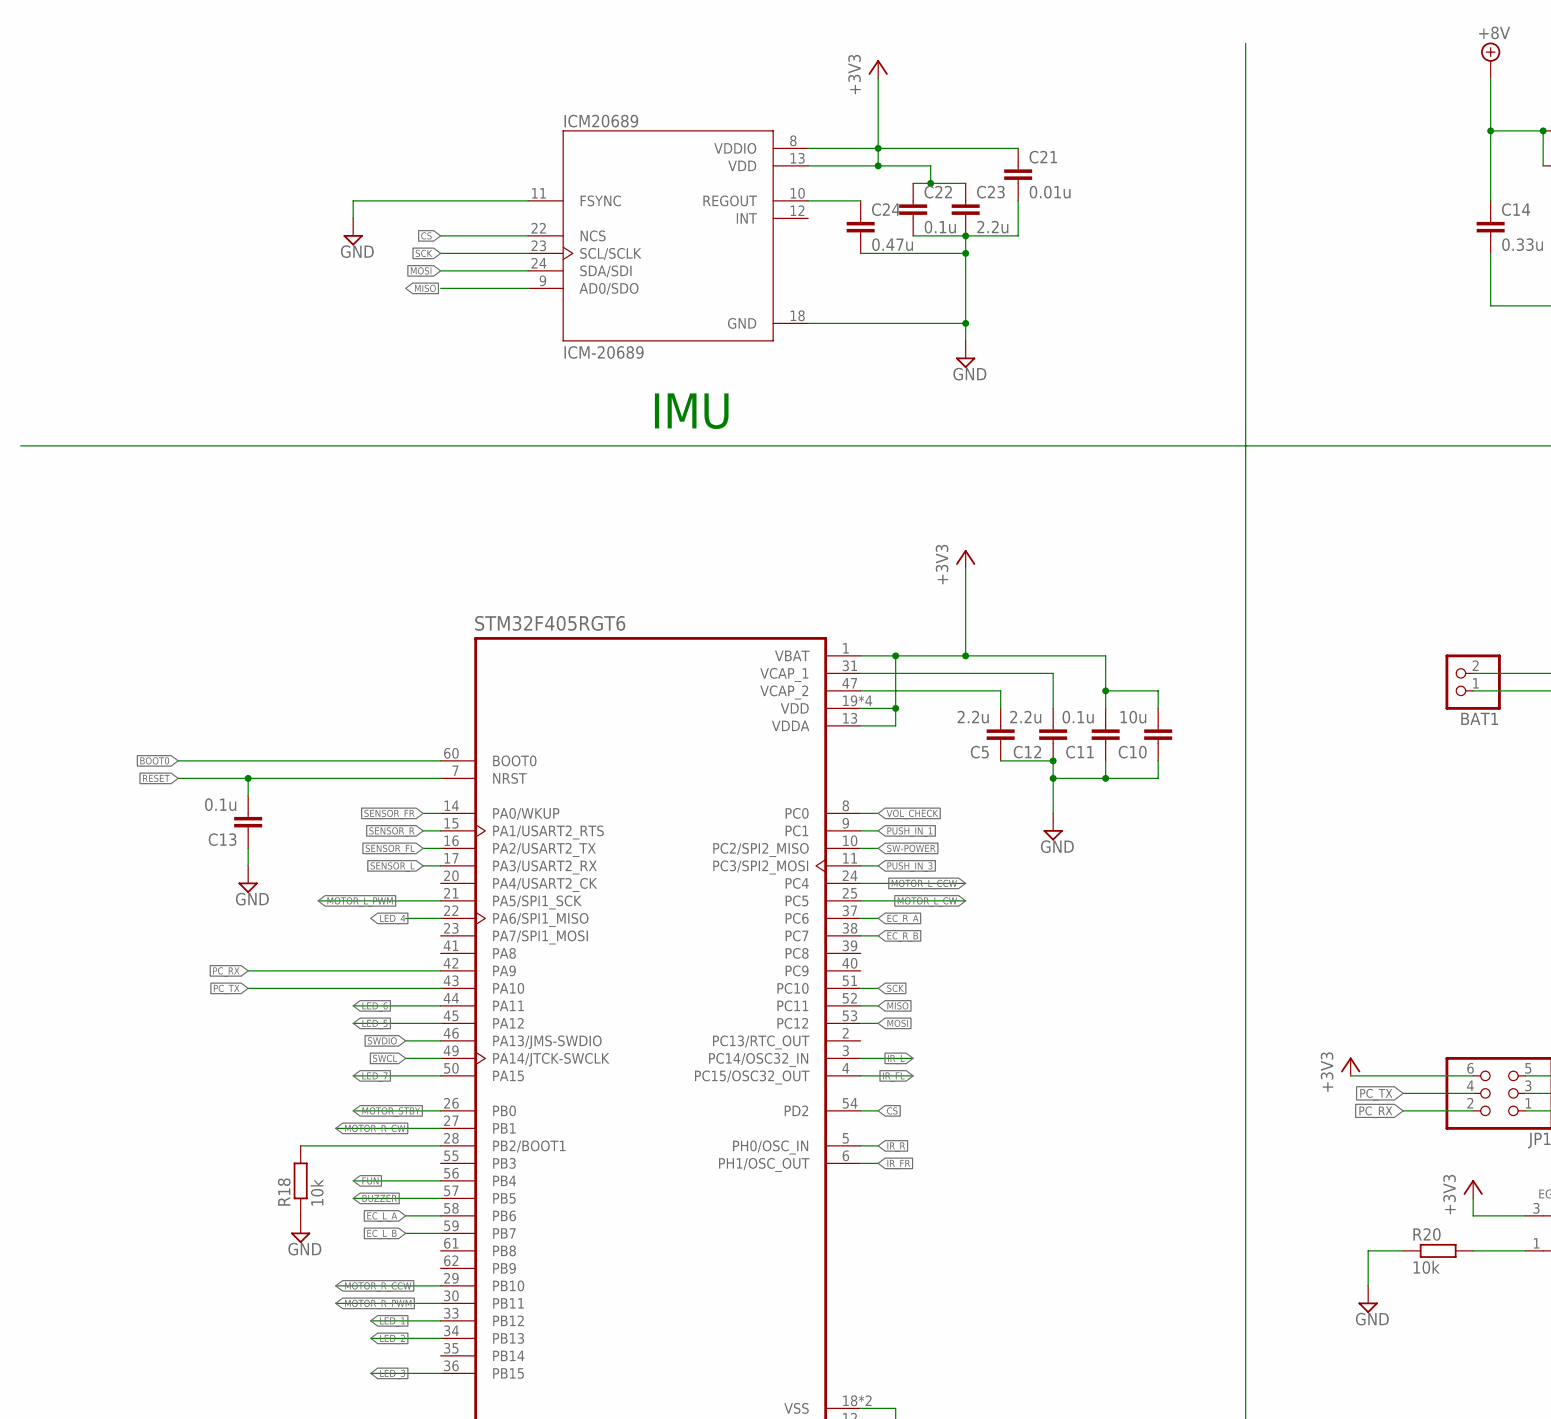
[picture p33: schematic passion-v2-1.sch, part in row 1, column 1]

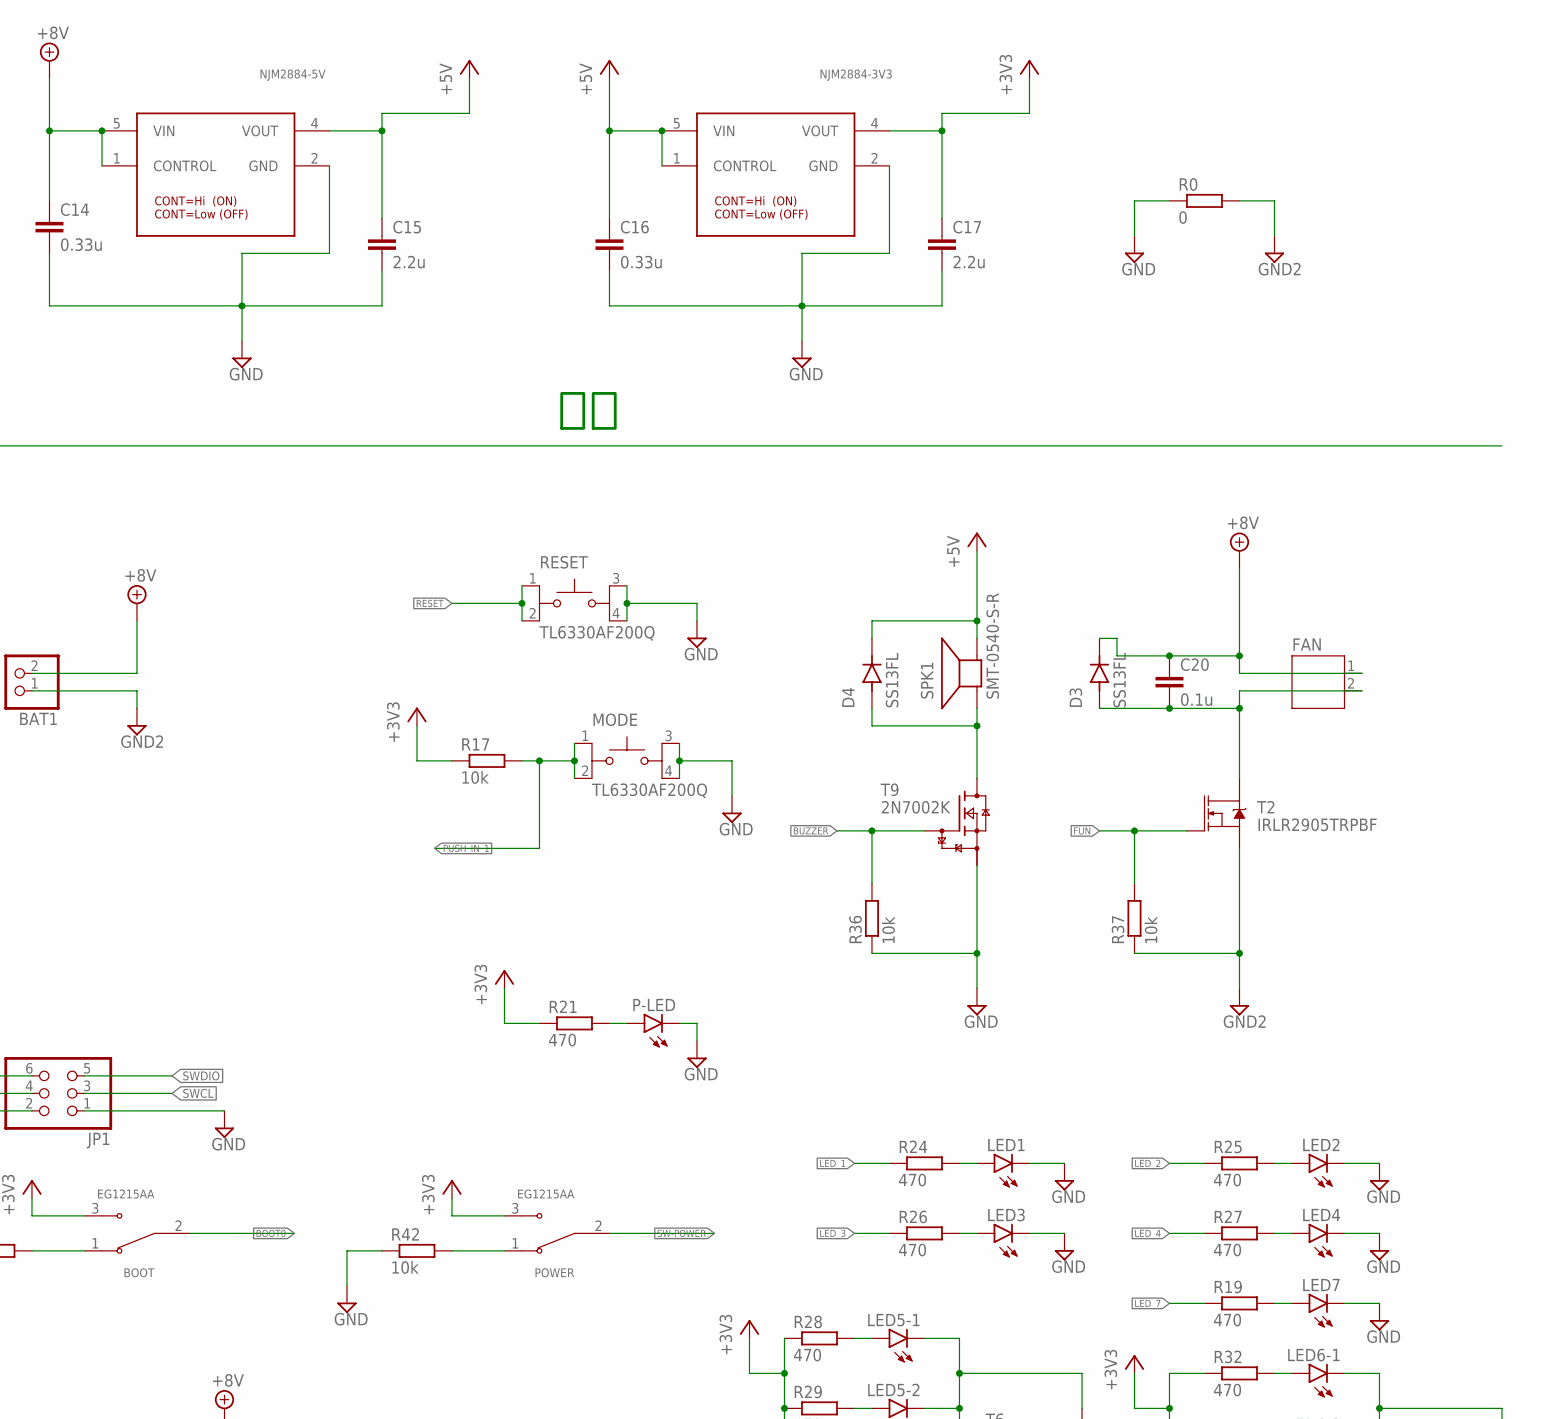
[picture p34: schematic passion-v2-1.sch, part in row 1, column 2]

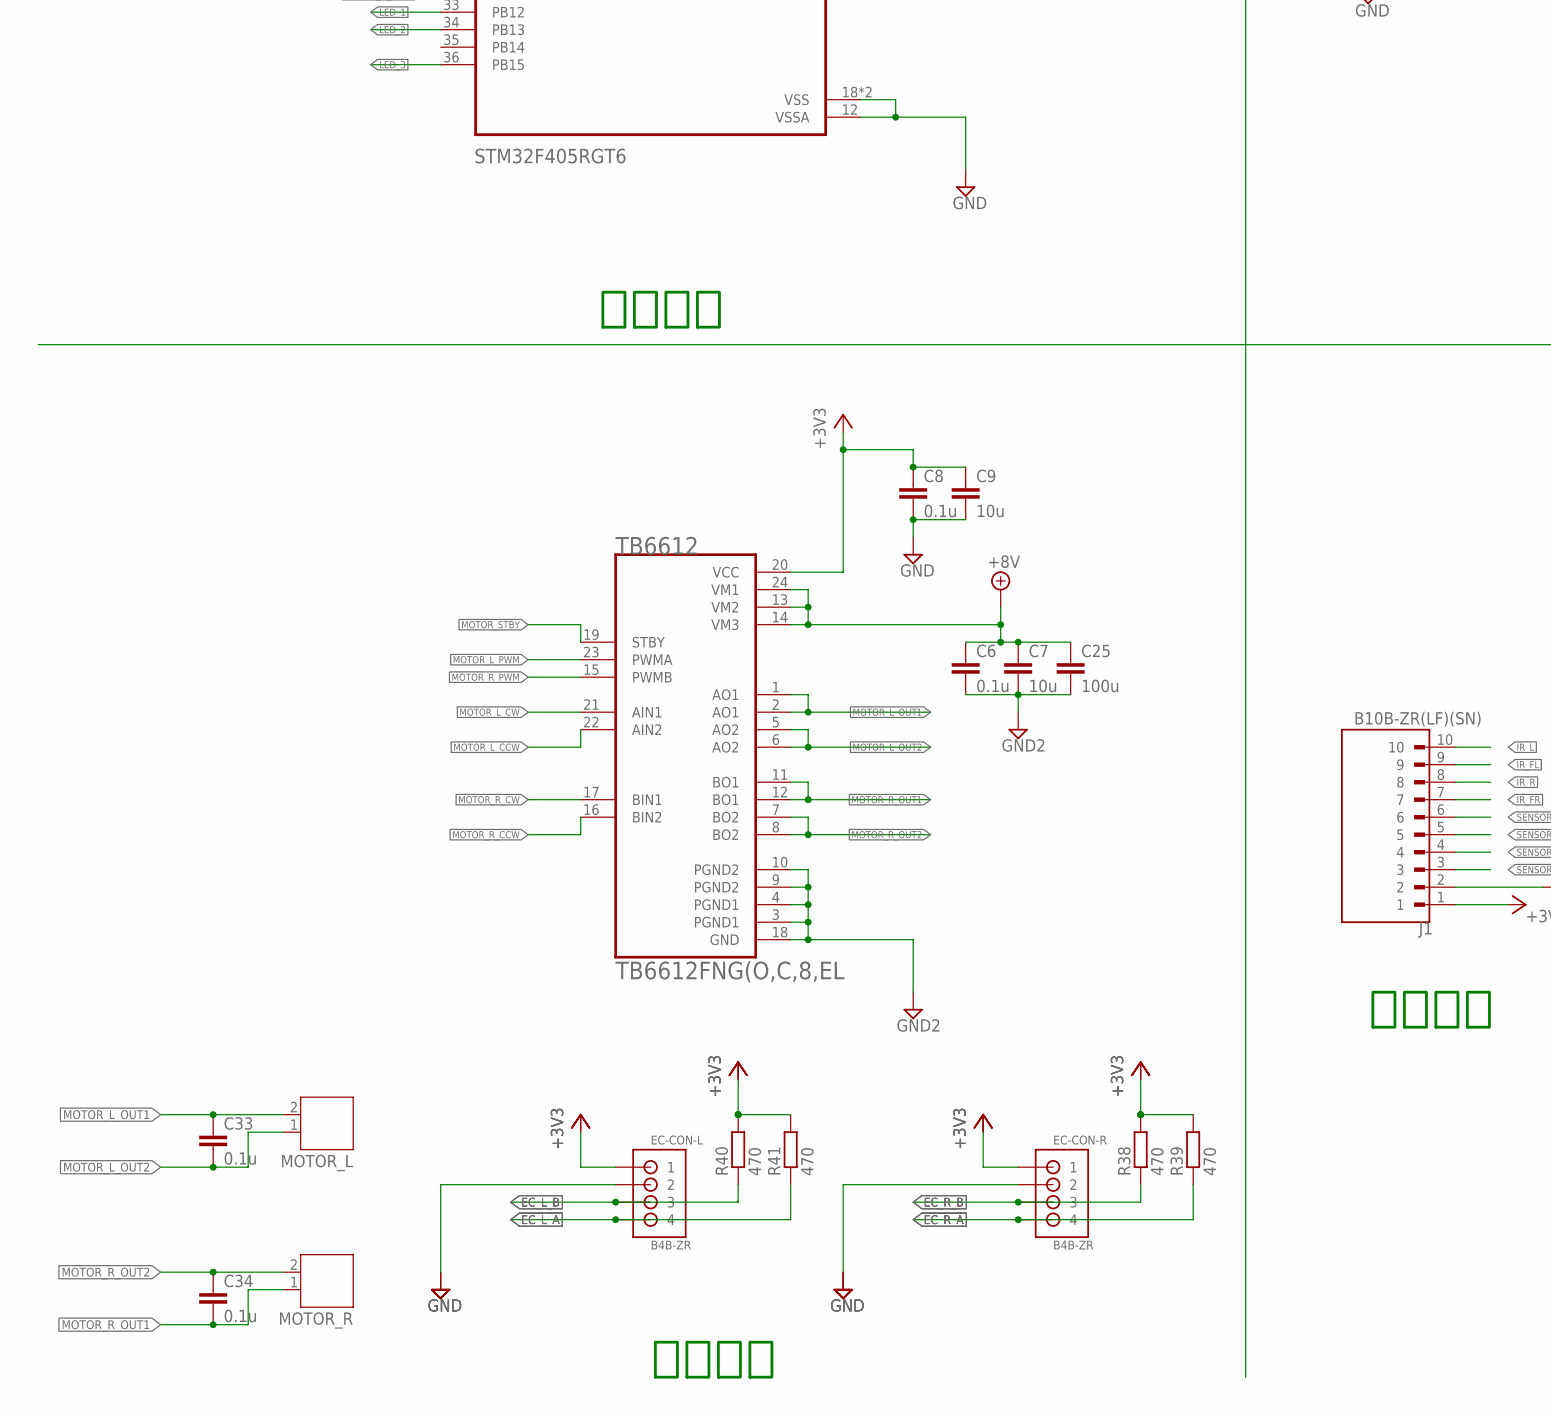
[picture p35: schematic passion-v2-1.sch, part in row 2, column 1]

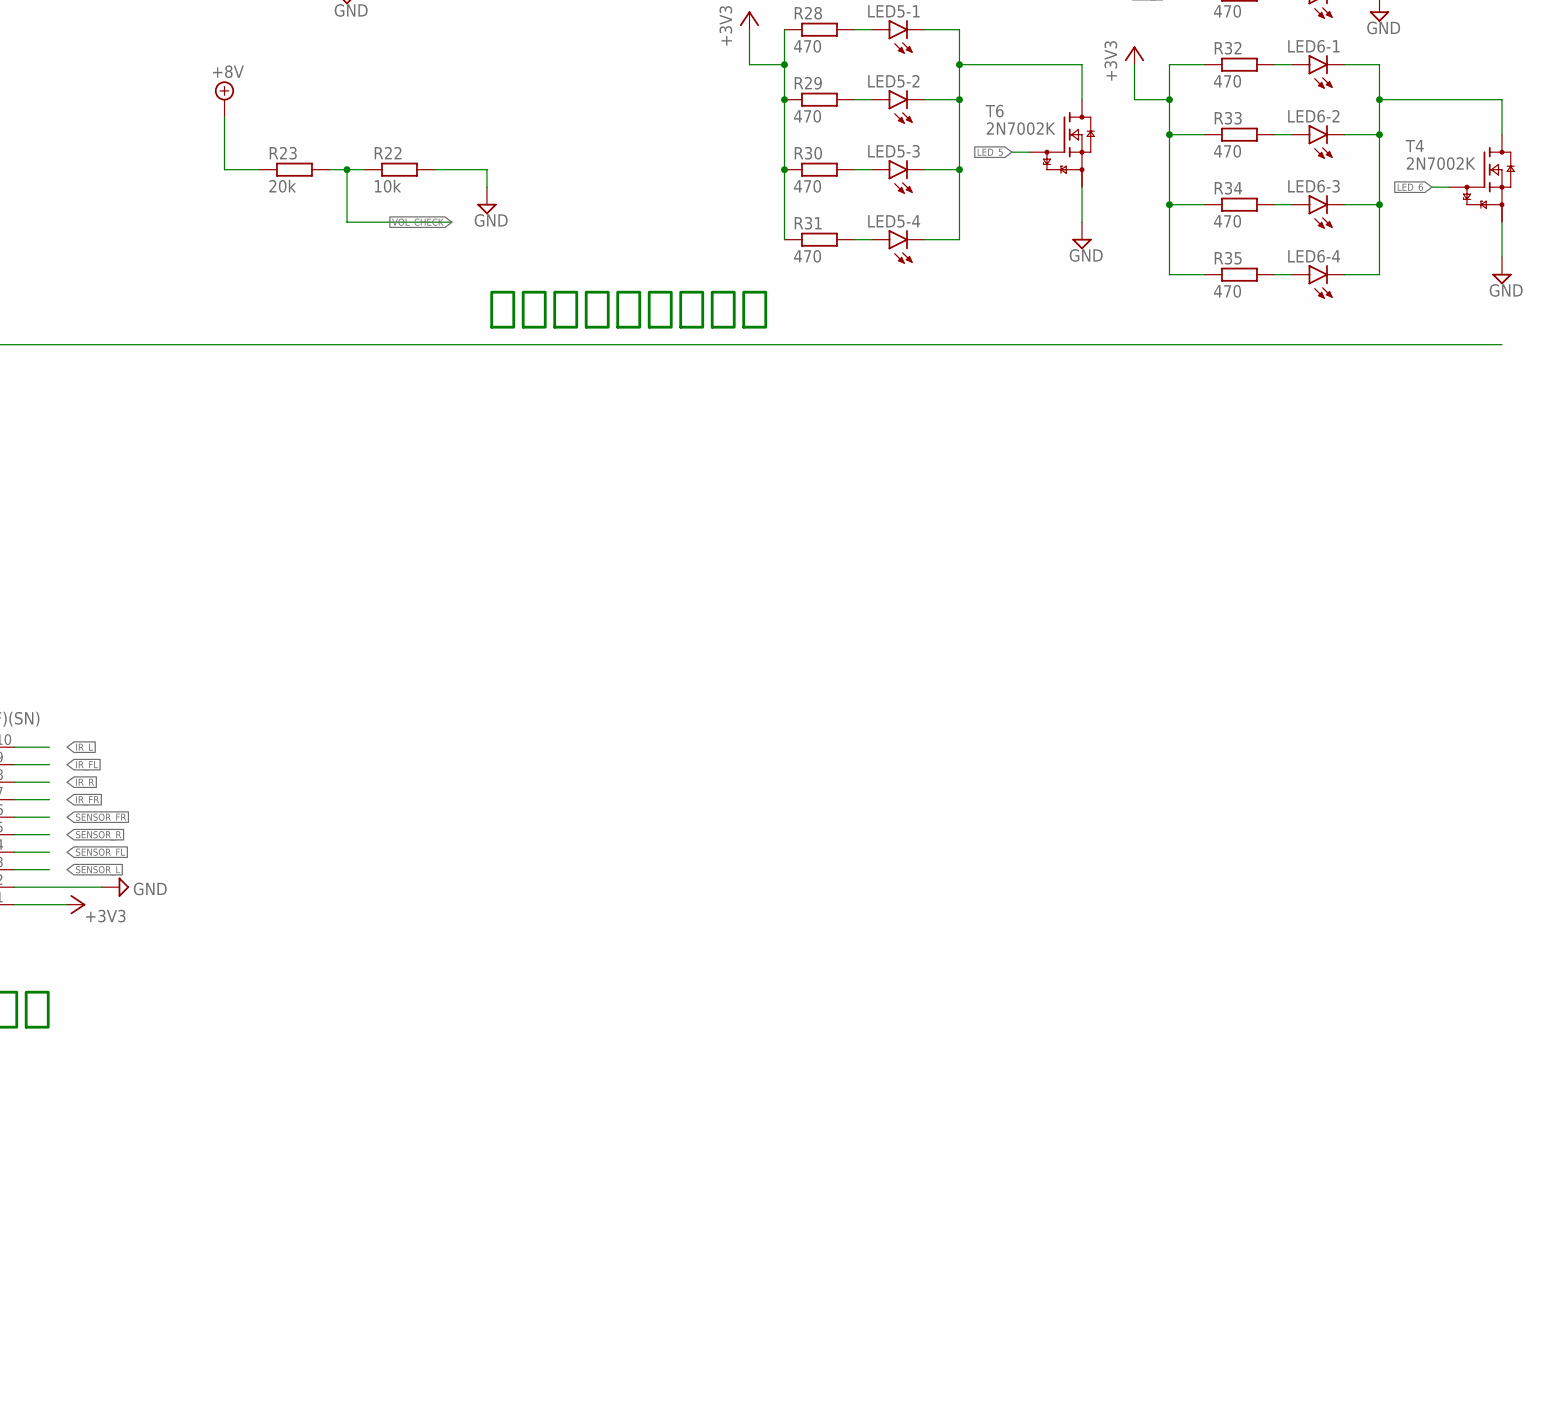
[picture p36: schematic passion-v2-1.sch, part in row 2, column 2]

Parts:
BAT1: PINHD-1X2; 1X02
BOOT: EG1215AA; SW_EG1215AA
C5, C12, C15, C17, C23: 2.2u; C0603
C6, C8, C11, C13, C20, C22, C33, C34: 0.1u; C0603
C7, C10: 10u; C0603
C9: 10u; C0603K
C14, C16: 0.33u; C0603
C21: 0.01u; C0603
C24: 0.47u; C0603
C25: 100u; C3216
D3, D4: SS13FL; SODFL3617X108N
EC-CON-L: B4B-ZR
EC-CON-R: B4B-ZR
FAN: JST-PH2
ICM20689: ICM-20689; QFN50P400X400X95-24N
J1: B10B-ZR(LF)(SN); JST_B10B-ZR(LF)(SN)
JP1: PINHD-2X3; 2X03
LED1, LED2, LED3, LED4, LED5-1, LED5-2, LED5-3, LED5-4, LED6-1, LED6-2, LED6-3, LED6-4, LED7: LEDCHIPLED_0603; CHIPLED_0603
MODE: TL6330AF200Q; SW_TL6330AF200Q
MOTOR_L: JST-PH2
MOTOR_R: JST-PH2
NJM2884-3V3, NJM2884-5V: I-10673_NJM2884U1-33; NJM2884U1-33
P-LED: LEDCHIPLED_0603; CHIPLED_0603
POWER: EG1215AA; SW_EG1215AA
R0: 0; R0603
R17, R18, R20, R22, R36, R37, R42: 10k; R0603
R19, R21, R24, R25, R26, R27, R28, R29, R30, R31, R32, R33, R34, R35: 470; R0603
R23: 20k; R0603
R38, R39, R40, R41: 470; R0402
RESET: TL6330AF200Q; SW_TL6330AF200Q
SPK1: SMT-0540-S-R
STM32F405RGT6: STM32F405RGT6; QFP50P1200X1200X160-64N
T2: IRLR2905TRPBF; TO252-3
T4, T6, T9: 2N7002K; SOT23
TB6612: TB6612FNG(O,C,8,EL; SOP65P760X160-24N

Connections:
+3V3: BOOT.3, C8.1, C9.1, C10.2, C11.2, C17.1, C21.1, C22.1, C23.1, EC-CON-L.1, EC-CON-R.1, ICM20689.8 (VDDIO), ICM20689.13 (VDD), J1.1, JP1.6, NJM2884-3V3.4 (VOUT), POWER.3, R17.1, R21.1, R28.1, R29.1, R30.1, R31.1, R32.1, R33.1, R34.1, R35.1, R38.2, R39.2, R40.2, R41.2, STM32F405RGT6.1 (VBAT), STM32F405RGT6.13 (VDDA), STM32F405RGT6.19 (VDD), STM32F405RGT6.32 (VDD), STM32F405RGT6.48 (VDD), STM32F405RGT6.64 (VDD), TB6612.20 (VCC)
+5V: C15.1, C16.1, D4.C, NJM2884-3V3.1 (CONTROL), NJM2884-3V3.5 (VIN), NJM2884-5V.4 (VOUT), SPK1.+ (-)
+8V: BAT1.2, C6.1, C7.1, C14.1, C20.1, C25.1, D3.C, FAN.1, NJM2884-5V.1 (CONTROL), NJM2884-5V.5 (VIN), R23.1, TB6612.13 (VM2), TB6612.14 (VM3), TB6612.24 (VM1)
BOOT0: BOOT.2, STM32F405RGT6.60 (BOOT0)
BUZZER: R36.2, STM32F405RGT6.57 (PB5), T9.1 (G)
CS: ICM20689.22 (NCS), STM32F405RGT6.54 (PD2)
EC_L_A: EC-CON-L.4, R41.1, STM32F405RGT6.58 (PB6)
EC_L_B: EC-CON-L.3, R40.1, STM32F405RGT6.59 (PB7)
EC_R_A: EC-CON-R.4, R39.1, STM32F405RGT6.37 (PC6)
EC_R_B: EC-CON-R.3, R38.1, STM32F405RGT6.38 (PC7)
FUN: R37.2, STM32F405RGT6.56 (PB4), T2.1 (G)
GND: C5.1, C8.2, C9.2, C10.1, C11.1, C12.1, C13.1, C14.2, C15.2, C16.2, C17.2, C21.2, C22.2, C23.2, C24.2, EC-CON-L.2, EC-CON-R.2, ICM20689.11 (FSYNC), ICM20689.18 (GND), J1.2, JP1.1, LED1.C, LED2.C, LED3.C, LED4.C, LED7.C, MODE.3, MODE.4, NJM2884-3V3.2 (GND), NJM2884-5V.2 (GND), P-LED.C, R0.1, R18.1, R20.1, R22.2, R36.1, R42.1, RESET.3, RESET.4, STM32F405RGT6.12 (VSSA), STM32F405RGT6.18 (VSS), STM32F405RGT6.63 (VSS), T4.2 (S), T6.2 (S), T9.2 (S)
GND2: BAT1.1, C6.2, C7.2, C25.2, R0.2, R37.1, T2.3 (S), TB6612.3 (PGND1), TB6612.4 (PGND1), TB6612.9 (PGND2), TB6612.10 (PGND2), TB6612.18 (GND)
IR_FL: J1.9, STM32F405RGT6.4 (PC15/OSC32_OUT)
IR_FR: J1.7, STM32F405RGT6.6 (PH1/OSC_OUT)
IR_L: J1.10, STM32F405RGT6.3 (PC14/OSC32_IN)
IR_R: J1.8, STM32F405RGT6.5 (PH0/OSC_IN)
LED_1: R24.1, STM32F405RGT6.33 (PB12)
LED_2: R25.1, STM32F405RGT6.34 (PB13)
LED_3: R26.1, STM32F405RGT6.36 (PB15)
LED_4: R27.1, STM32F405RGT6.22 (PA6/SPI1_MISO)
LED_5: STM32F405RGT6.45 (PA12), T6.1 (G)
LED_6: STM32F405RGT6.44 (PA11), T4.1 (G)
LED_7: R19.1, STM32F405RGT6.50 (PA15)
MISO: ICM20689.9 (AD0/SDO), STM32F405RGT6.52 (PC11)
MOSI: ICM20689.24 (SDA/SDI), STM32F405RGT6.53 (PC12)
MOTOR_L_CCW: STM32F405RGT6.24 (PC4), TB6612.22 (AIN2)
MOTOR_L_CW: STM32F405RGT6.25 (PC5), TB6612.21 (AIN1)
MOTOR_L_OUT1: C33.1, MOTOR_L.2, TB6612.1 (AO1), TB6612.2 (AO1)
MOTOR_L_OUT2: C33.2, MOTOR_L.1, TB6612.5 (AO2), TB6612.6 (AO2)
MOTOR_L_PWM: STM32F405RGT6.21 (PA5/SPI1_SCK), TB6612.23 (PWMA)
MOTOR_R_CCW: STM32F405RGT6.29 (PB10), TB6612.16 (BIN2)
MOTOR_R_CW: STM32F405RGT6.27 (PB1), TB6612.17 (BIN1)
MOTOR_R_OUT1: C34.2, MOTOR_R.1, TB6612.11 (BO1), TB6612.12 (BO1)
MOTOR_R_OUT2: C34.1, MOTOR_R.2, TB6612.7 (BO2), TB6612.8 (BO2)
MOTOR_R_PWM: STM32F405RGT6.30 (PB11), TB6612.15 (PWMB)
MOTOR_STBY: STM32F405RGT6.26 (PB0), TB6612.19 (STBY)
unnamed: C5.2, STM32F405RGT6.47 (VCAP_2)
unnamed: C12.2, STM32F405RGT6.31 (VCAP_1)
unnamed: R18.2, STM32F405RGT6.28 (PB2/BOOT1)
unnamed: LED5-2.A, R29.2
unnamed: LED5-3.A, R30.2
unnamed: LED5-4.A, R31.2
unnamed: BOOT.1, R20.2
unnamed: C24.1, ICM20689.10 (REGOUT)
unnamed: P-LED.A, R21.2
unnamed: C20.2, D3.A, FAN.2, T2.2 (D), T2.PAD (D)
unnamed: D4.A, SPK1.- (+), T9.3 (D)
unnamed: LED6-2.A, R33.2
unnamed: LED1.A, R24.2
unnamed: LED6-3.A, R34.2
unnamed: LED6-4.A, R35.2
unnamed: POWER.1, R42.2
unnamed: LED4.A, R27.2
unnamed: LED5-1.A, R28.2
unnamed: LED7.A, R19.2
unnamed: LED2.A, R25.2
unnamed: LED6-1.C, LED6-2.C, LED6-3.C, LED6-4.C, T4.3 (D)
unnamed: LED5-1.C, LED5-2.C, LED5-3.C, LED5-4.C, T6.3 (D)
unnamed: LED3.A, R26.2
unnamed: LED6-1.A, R32.2
PC_RX: JP1.2, STM32F405RGT6.42 (PA9)
PC_TX: JP1.4, STM32F405RGT6.43 (PA10)
PUSH_IN_1: MODE.1, MODE.2, R17.2, STM32F405RGT6.9 (PC1)
PUSH_IN_3: STM32F405RGT6.11 (PC3/SPI2_MOSI)
RESET: C13.2, RESET.1, RESET.2, STM32F405RGT6.7 (NRST)
SCK: ICM20689.23 (SCL/SCLK), STM32F405RGT6.51 (PC10)
SENSOR_FL: J1.4, STM32F405RGT6.16 (PA2/USART2_TX)
SENSOR_FR: J1.6, STM32F405RGT6.14 (PA0/WKUP)
SENSOR_L: J1.3, STM32F405RGT6.17 (PA3/USART2_RX)
SENSOR_R: J1.5, STM32F405RGT6.15 (PA1/USART2_RTS)
SW-POWER: POWER.2, STM32F405RGT6.10 (PC2/SPI2_MISO)
SWCL: JP1.3, STM32F405RGT6.49 (PA14/JTCK-SWCLK)
SWDIO: JP1.5, STM32F405RGT6.46 (PA13/JMS-SWDIO)
VOL_CHECK: R22.1, R23.2, STM32F405RGT6.8 (PC0)

Notes on the sheet:
マイコン
インターフェース他
モータ系
センサ系
IMU

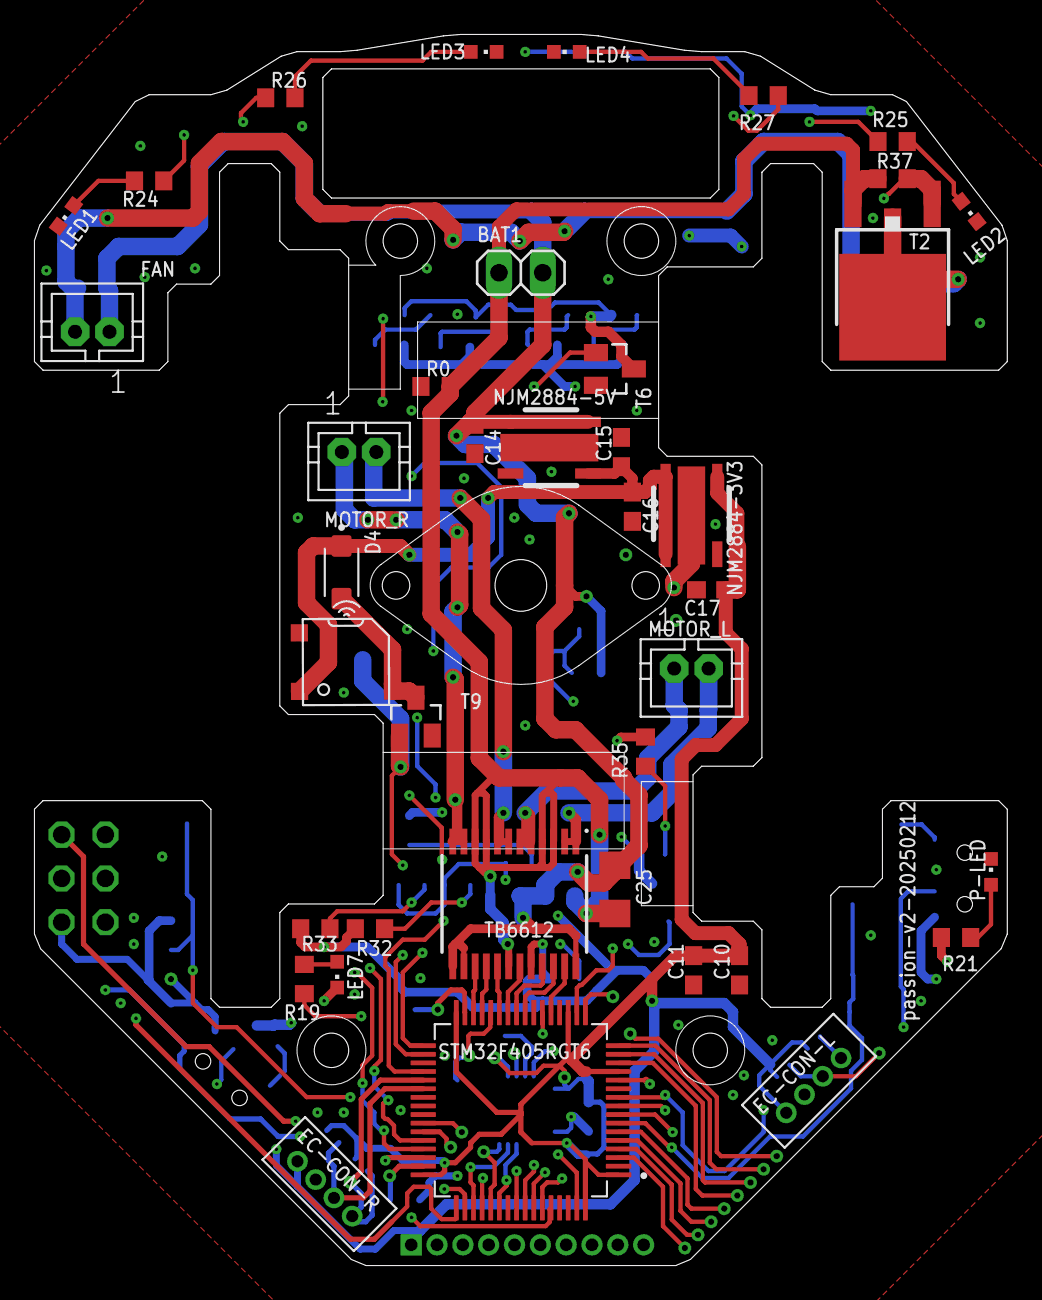
[picture p37: board passion-v2-1.brd from above]

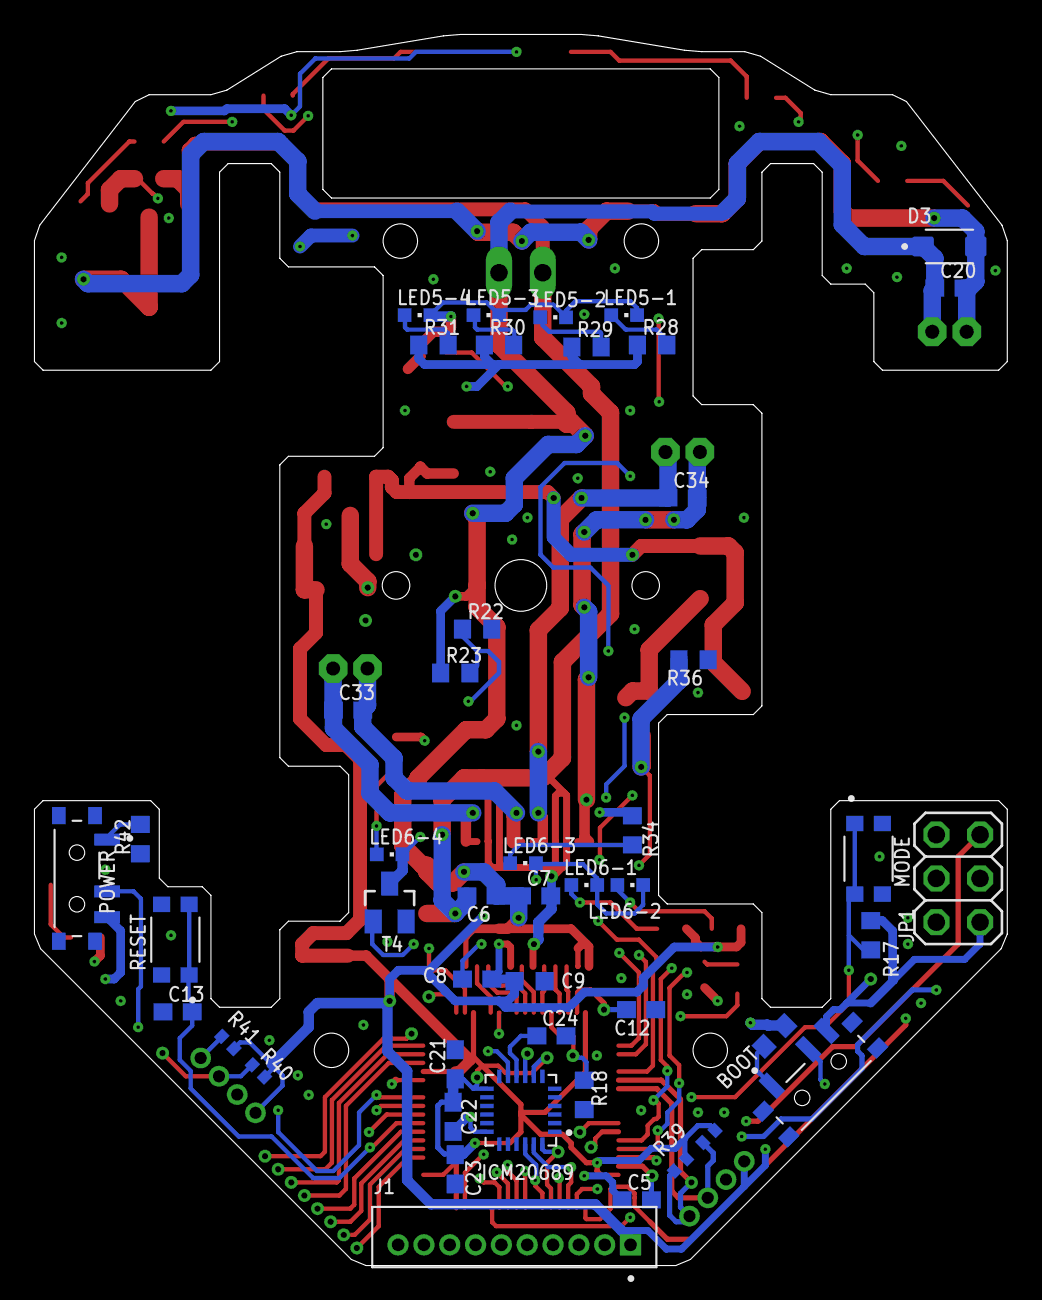
[picture p38: board passion-v2-1.brd from below]

Board: 4 copper layers, 56.5 x 71.5 mm, 86 parts (47 on the bottom side), 74 nets.
