mhonda0119/Passion-v2/Eagle/passion-v2-1/sensor-hub-fr-fl.brd

## EAGLE design Eagle/passion-v2-1/sensor-hub-fr-fl.brd (2025-03-03)

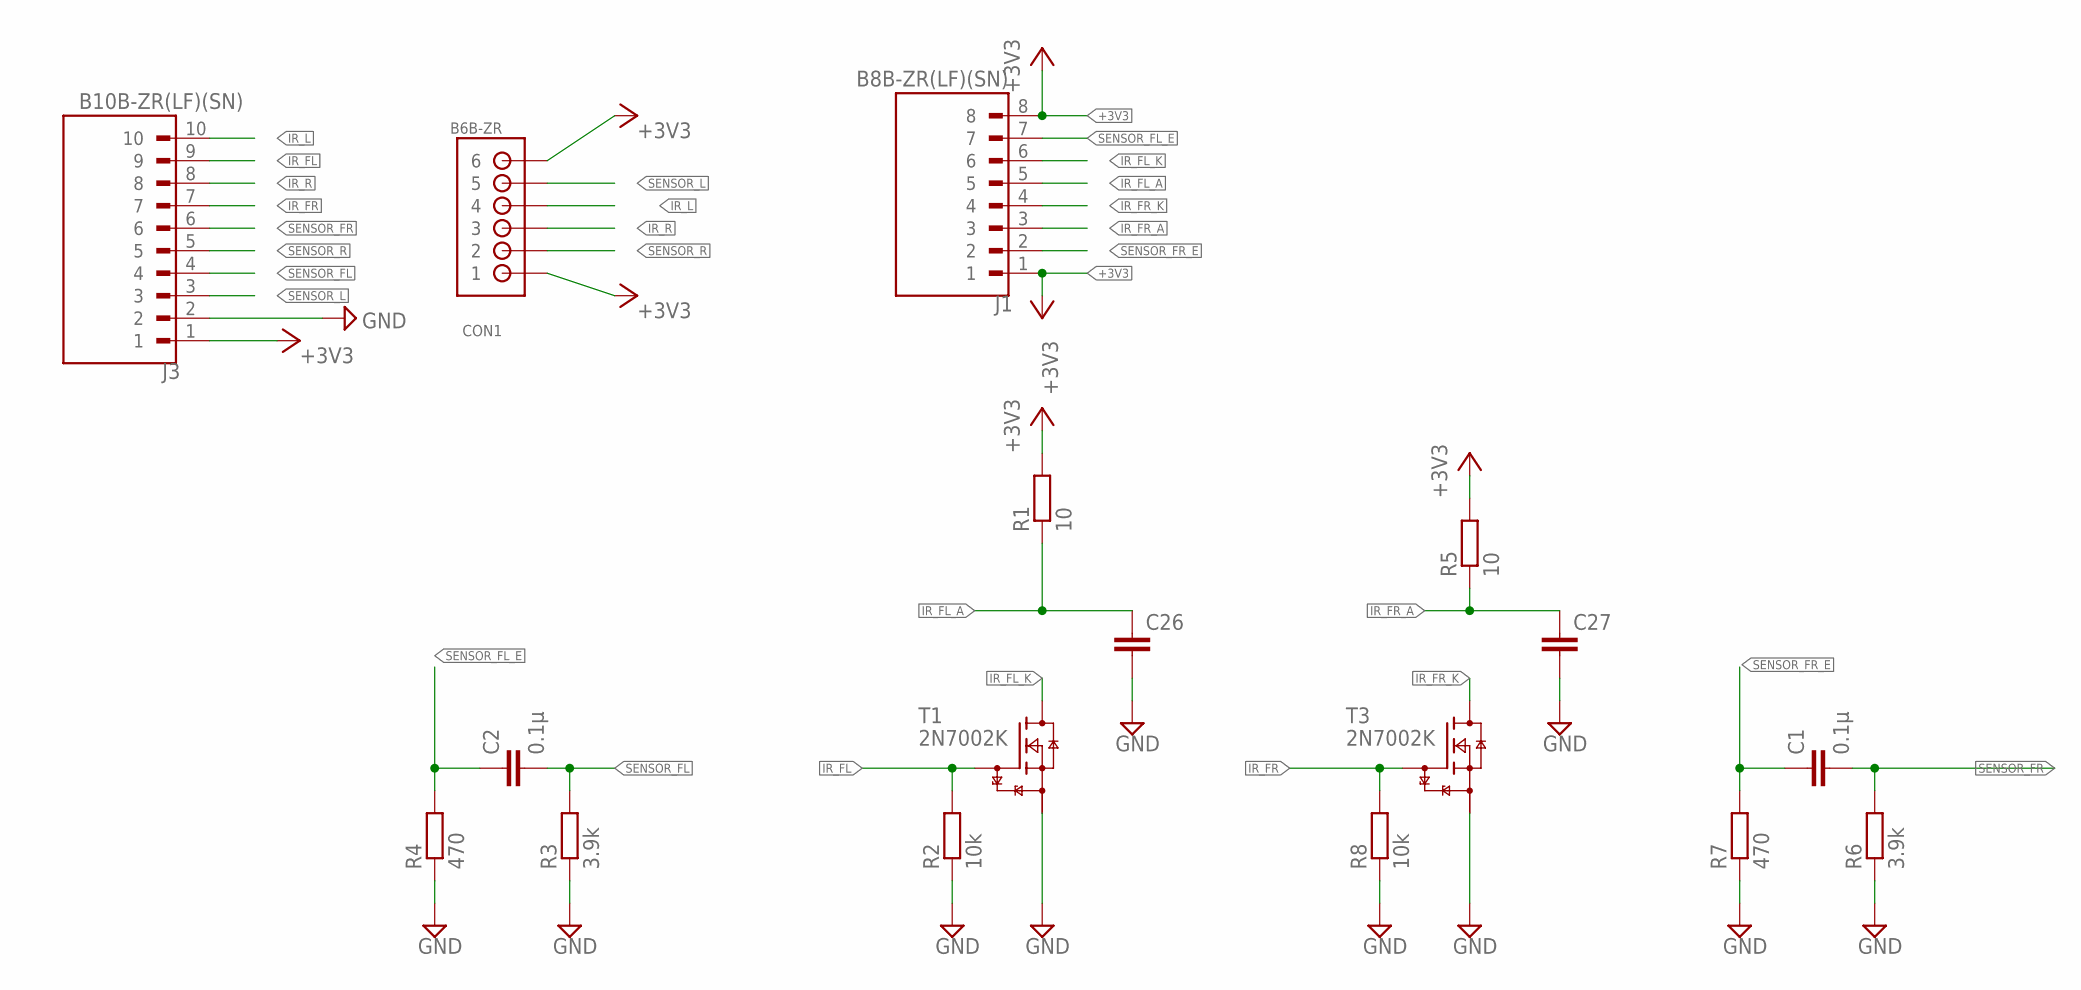
[picture p39: schematic sensor-hub-fr-fl.sch]

Parts:
C1, C2: 0.1μ; C0603
C26, C27: C-EUC1206; C1206
CON1: B6B-ZR
J1: B8B-ZR(LF)(SN); JST_B8B-ZR(LF)(SN)
J3: B10B-ZR(LF)(SN); JST_B10B-ZR(LF)(SN)
R1, R5: 10; R0603
R2, R8: 10k; R0603
R3, R6: 3.9k; R0603
R4, R7: 470; R0603
T1, T3: 2N7002K; SOT23

Connections:
+3V3: CON1.1, CON1.6, J1.1, J1.8, J3.1, R1.2, R5.2
GND: C26.2, C27.2, J3.2, R2.1, R3.1, R4.1, R6.1, R7.1, R8.1, T1.2 (S), T3.2 (S)
IR_FL: J3.9, R2.2, T1.1 (G)
IR_FL_A: C26.1, J1.5, R1.1
IR_FL_K: J1.6, T1.3 (D)
IR_FR: J3.7, R8.2, T3.1 (G)
IR_FR_A: C27.1, J1.3, R5.1
IR_FR_K: J1.4, T3.3 (D)
IR_L: CON1.4, J3.10
IR_R: CON1.3, J3.8
SENSOR_FL: C2.2, J3.4, R3.2
SENSOR_FL_E: C2.1, J1.7, R4.2
SENSOR_FR: C1.2, J3.6, R6.2
SENSOR_FR_E: C1.1, J1.2, R7.2
SENSOR_L: CON1.5, J3.3
SENSOR_R: CON1.2, J3.5

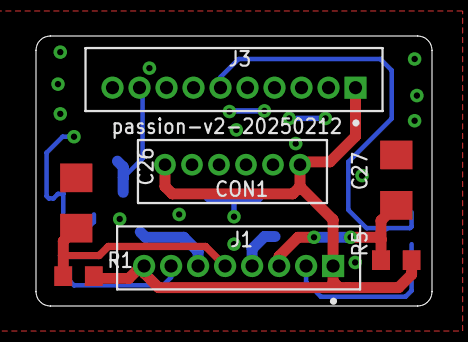
[picture p40: board sensor-hub-fr-fl.brd from above]

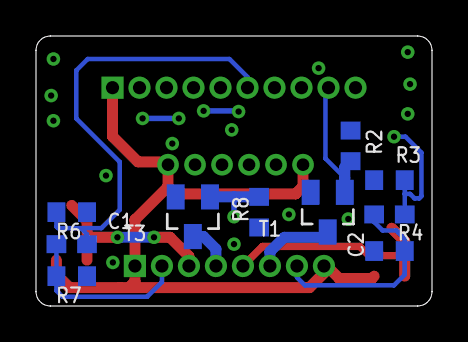
[picture p41: board sensor-hub-fr-fl.brd from below]

Board: 4 copper layers, 22.0 x 15.0 mm, 17 parts (10 on the bottom side), 16 nets.
