mhonda0119/Passion-v2/CubeMX/passion-v2-1/passion-v2-1.ioc

Mcu.UserName=STM32F405RGTx
PA0-WKUP.GPIO_Label=SENSOR_FR
PA0-WKUP.Signal=ADCx_IN0
PA1.GPIO_Label=SENSOR_R
PA1.Signal=ADCx_IN1
PA10.GPIO_Label=PC_TX
PA10.Signal=USART1_RX
PA11.GPIO_Label=LED_6
PA11.Signal=GPIO_Output
PA12.GPIO_Label=LED_5
PA12.Signal=GPIO_Output
PA13.GPIO_Label=SWDIO
PA13.Signal=SYS_JTMS-SWDIO
PA14.GPIO_Label=SWCL
PA14.Signal=SYS_JTCK-SWCLK
PA15.GPIO_Label=LED_7
PA15.Signal=GPIO_Output
PA2.GPIO_Label=SENSOR_FL
PA2.Signal=ADCx_IN2
PA3.GPIO_Label=SENSOR_L
PA3.Signal=ADCx_IN3
PA5.GPIO_Label=MOTOR_L_PWM
PA5.Signal=S_TIM2_CH1_ETR
PA6.GPIO_Label=LED_4
PA6.Signal=GPIO_Output
PA9.GPIO_Label=PC_RX
PA9.Signal=USART1_TX
PB0.GPIO_Label=MOTOR_STBY
PB0.Signal=GPIO_Output
PB1.GPIO_Label=MOTOR_R_CW
PB1.Signal=GPIO_Output
PB10.GPIO_Label=MOTOR_R_CCW
PB10.Signal=GPIO_Output
PB11.GPIO_Label=MOTOR_R_PWM
PB11.Signal=S_TIM2_CH4
PB12.GPIO_Label=LED_1
PB12.Signal=GPIO_Output
PB13.GPIO_Label=LED_2
PB13.Signal=GPIO_Output
PB15.GPIO_Label=LED_3
PB15.Signal=GPIO_Output
PB4.GPIO_Label=FAN
PB4.Signal=S_TIM3_CH1
PB5.GPIO_Label=BUZZER
PB5.Signal=S_TIM3_CH2
PB6.GPIO_Label=EC_L_A
PB6.Signal=S_TIM4_CH1
PB7.GPIO_Label=EC_L_B
PB7.Signal=S_TIM4_CH2
PC0.GPIO_Label=VOL_CHECK
PC0.Signal=ADCx_IN10
PC1.GPIO_Label=PUSH_IN_1
PC1.Signal=GPIO_Input
PC10.GPIO_Label=SCK
PC10.Signal=SPI3_SCK
PC11.GPIO_Label=MISO
PC11.Signal=SPI3_MISO
PC12.GPIO_Label=MOSI
PC12.Signal=SPI3_MOSI
PC14-OSC32_IN.GPIO_Label=IR_L
PC14-OSC32_IN.Signal=GPIO_Output
PC15-OSC32_OUT.GPIO_Label=IR_FL
PC15-OSC32_OUT.Signal=GPIO_Output
PC2.GPIO_Label=SW_POWER
PC2.Signal=GPIO_Input
PC3.GPIO_Label=PUSH_IN_3
PC3.Signal=GPIO_Input
PC4.GPIO_Label=MOTOR_L_CCW
PC4.Signal=GPIO_Input
PC5.GPIO_Label=MOTOR_L_CW
PC5.Signal=GPIO_Input
PC6.GPIO_Label=EC_R_A
PC6.Signal=S_TIM8_CH1
PC7.GPIO_Label=EC_R_B
PC7.Signal=S_TIM8_CH2
PD2.GPIO_Label=CS
PD2.Signal=GPIO_Output
PH0-OSC_IN.GPIO_Label=IR_R
PH0-OSC_IN.Signal=GPIO_Output
PH1-OSC_OUT.GPIO_Label=IR_FR
PH1-OSC_OUT.Signal=GPIO_Output
