mhonda0119/Passion-v2/CubeMX/passion-v2-1/Core/Inc/main.h

#define IR_L_Pin GPIO_PIN_14
#define IR_L_GPIO_Port GPIOC
#define IR_FL_Pin GPIO_PIN_15
#define IR_FL_GPIO_Port GPIOC
#define IR_R_Pin GPIO_PIN_0
#define IR_R_GPIO_Port GPIOH
#define IR_FR_Pin GPIO_PIN_1
#define IR_FR_GPIO_Port GPIOH
#define VOL_CHECK_Pin GPIO_PIN_0
#define VOL_CHECK_GPIO_Port GPIOC
#define PUSH_IN_1_Pin GPIO_PIN_1
#define PUSH_IN_1_GPIO_Port GPIOC
#define SW_POWER_Pin GPIO_PIN_2
#define SW_POWER_GPIO_Port GPIOC
#define PUSH_IN_3_Pin GPIO_PIN_3
#define PUSH_IN_3_GPIO_Port GPIOC
#define SENSOR_FR_Pin GPIO_PIN_0
#define SENSOR_FR_GPIO_Port GPIOA
#define SENSOR_R_Pin GPIO_PIN_1
#define SENSOR_R_GPIO_Port GPIOA
#define SENSOR_FL_Pin GPIO_PIN_2
#define SENSOR_FL_GPIO_Port GPIOA
#define SENSOR_L_Pin GPIO_PIN_3
#define SENSOR_L_GPIO_Port GPIOA
#define MOTOR_L_PWM_Pin GPIO_PIN_5
#define MOTOR_L_PWM_GPIO_Port GPIOA
#define LED_4_Pin GPIO_PIN_6
#define LED_4_GPIO_Port GPIOA
#define MOTOR_L_CCW_Pin GPIO_PIN_4
#define MOTOR_L_CCW_GPIO_Port GPIOC
#define MOTOR_L_CW_Pin GPIO_PIN_5
#define MOTOR_L_CW_GPIO_Port GPIOC
#define MOTOR_STBY_Pin GPIO_PIN_0
#define MOTOR_STBY_GPIO_Port GPIOB
#define MOTOR_R_CW_Pin GPIO_PIN_1
#define MOTOR_R_CW_GPIO_Port GPIOB
#define MOTOR_R_CCW_Pin GPIO_PIN_10
#define MOTOR_R_CCW_GPIO_Port GPIOB
#define MOTOR_R_PWM_Pin GPIO_PIN_11
#define MOTOR_R_PWM_GPIO_Port GPIOB
#define LED_1_Pin GPIO_PIN_12
#define LED_1_GPIO_Port GPIOB
#define LED_2_Pin GPIO_PIN_13
#define LED_2_GPIO_Port GPIOB
#define LED_3_Pin GPIO_PIN_15
#define LED_3_GPIO_Port GPIOB
#define EC_R_A_Pin GPIO_PIN_6
#define EC_R_A_GPIO_Port GPIOC
#define EC_R_B_Pin GPIO_PIN_7
#define EC_R_B_GPIO_Port GPIOC
#define PC_RX_Pin GPIO_PIN_9
#define PC_RX_GPIO_Port GPIOA
#define PC_TX_Pin GPIO_PIN_10
#define PC_TX_GPIO_Port GPIOA
#define LED_6_Pin GPIO_PIN_11
#define LED_6_GPIO_Port GPIOA
#define LED_5_Pin GPIO_PIN_12
#define LED_5_GPIO_Port GPIOA
#define SWDIO_Pin GPIO_PIN_13
#define SWDIO_GPIO_Port GPIOA
#define SWCL_Pin GPIO_PIN_14
#define SWCL_GPIO_Port GPIOA
#define LED_7_Pin GPIO_PIN_15
#define LED_7_GPIO_Port GPIOA
#define SCK_Pin GPIO_PIN_10
#define SCK_GPIO_Port GPIOC
#define MISO_Pin GPIO_PIN_11
#define MISO_GPIO_Port GPIOC
#define MOSI_Pin GPIO_PIN_12
#define MOSI_GPIO_Port GPIOC
#define CS_Pin GPIO_PIN_2
#define CS_GPIO_Port GPIOD
#define FAN_Pin GPIO_PIN_4
#define FAN_GPIO_Port GPIOB
#define BUZZER_Pin GPIO_PIN_5
#define BUZZER_GPIO_Port GPIOB
#define EC_L_A_Pin GPIO_PIN_6
#define EC_L_A_GPIO_Port GPIOB
#define EC_L_B_Pin GPIO_PIN_7
#define EC_L_B_GPIO_Port GPIOB
