mhonda0119/Passion-v2/CubeMX/passion-v2-1/App/Src/peripheral/adc.cpp

#include "adc.hpp"

namespace peripheral{
	ADC::ADC(ADC_HandleTypeDef* hadc)
	:hadc_(hadc){}
	
	void ADC::ReadVal(){//,uint32_t rank)
		HAL_ADC_Start_DMA(hadc_,(uint32_t *)buff_,channels_);
	}

	uint16_t* ADC::get_val_ptr(){
		return buff_;
	}
}
