mhonda0119/Passion-v2/(notices)

Notices in the files:
CubeMX/passion-v2-1/Core/Src/main.cpp:
Copyright (c) 2025 STMicroelectronics.
All rights reserved.
This software is licensed under terms that can be found in the LICENSE file
